EnesCanbolat/EE464_Project/PCB Design/Saturn Validation/via_validation.JPG

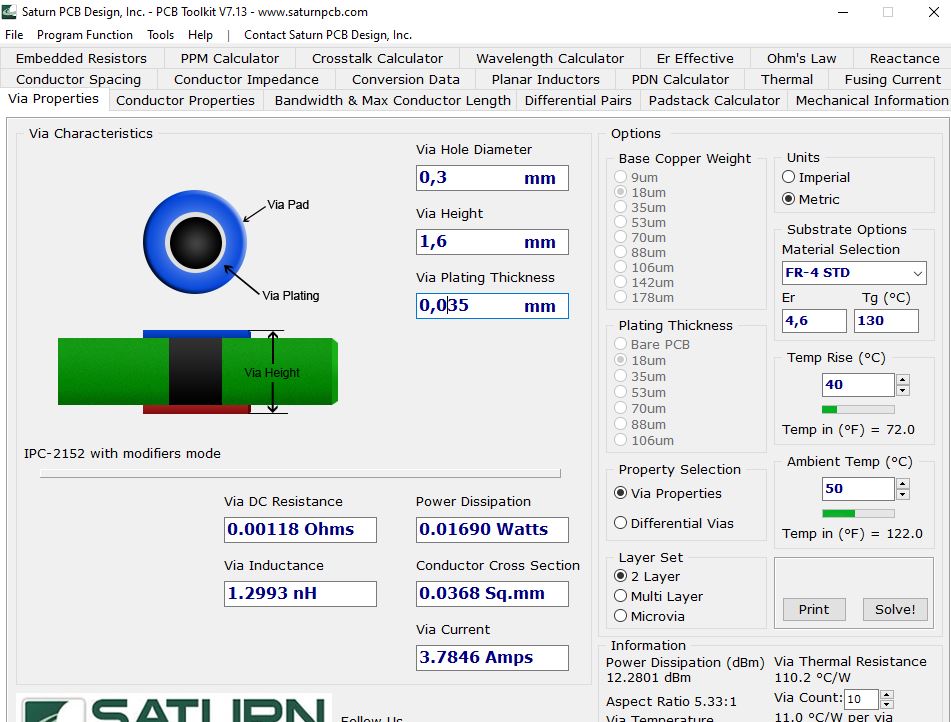
PCB Design/Saturn Validation/via_validation.JPG
