EnesCanbolat/EE464_Project/PCB Design/Saturn Validation/conductor_validation.JPG

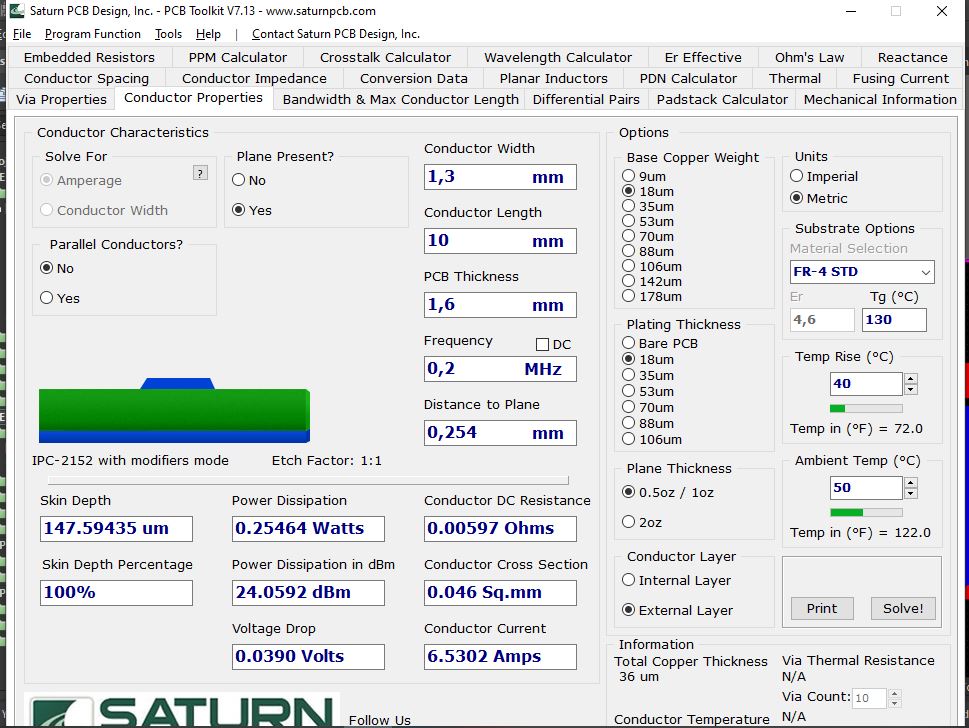
PCB Design/Saturn Validation/conductor_validation.JPG
