EnesCanbolat/EE464_Project/Report/Finished Parts/Hardware Design.docx

Hardware Design

a. Schematic Design

In this project, we have designed a schematic for our Flyback Converter hardware, by considering detailed simulation with LT8316 and DC2718A Demo Board Schematic, which is a 16V-600V input, 12V-3A output Flyback Converter demo board with LT8316. As a consequence of having a capable controller and tertiary winding transformer, we do not need any digital isolator (i.e. optocoupler) between two isolation boundaries. So, we have concluded our schematic with controller, transformer, connectors and some discrete components (discussed in component selection part) such as resistors, capacitors, diodes. We have not needed any extra ICs.

In component selection part, we have discussed feedback resistors, UVLO resistors and sense resistor for controller. However, there are some additional recommended components, that we placed in our schematic design. We can have a short discussion about these components:

IntVcc Pin: This pin is to maintain internal supply voltage that is taken from the Bias pin. In order to do that, datasheet recommends minimum 2.2uF capacitor, in schematic we have placed a 4.7uF capacitor.

Bias Pin: This pin takes the internal supply voltage from tertiary windings, so the datasheet recommends a bypass capacitor to ground. We have placed a 4.7uF ceramic capacitor, again.

Smode Pin: This pin is used for stand-by operation. In order yo avoid that we have connected it to ground.

Vc Pin: This pin is the Loop Compensation pin, which determines the switching frequency from the feedback voltage. Datasheet recommends an R-C network to stabilize the regulation generally with 20kohm resistor and 220nF capacitor. Normally decreasing R value and increasing C value causes transient problems and increasing R value and decreasing C value causes high frequency problems. However, when we examine the demo board discussed above, the R-C network is constructed with 10kohm resistor and 100nF capacitor. When we compare these values with the datasheet recommendation, we see that the demo board application gives better transient values, so we have used 10kohm resistor and 100nF capacitor in our hardware design.

IREG/SS Pin: This pin helps to regulate the output current. From this pin, 10uA current flows, and with the connected resistor, the voltage drop on the pin adjusts the current regulation. When we look datasheet, a formula is provided for this pin’s resistor, so when we calculate the needed resistor for 8.33A output current, we see that we need to connect a 50kohm resistor between this pin and ground.

TC Pin: This pin is used for Temperature Compensation, and from this pin to feedback pin a temperature compensation resistor is connected. Normally, there is a temperature coefficient that is found experimentally from the output diode voltage and temperature change, than the required resistance of this pin is calculated from this coefficient. However, in this project we are not able to implement that test, so we will use the demo board’s TC resistor which is 121kohm.

In addition to these recommended components by datasheet, we have used some additional components, which are input ceramic capacitors to compensate high frequency problems from input, and we have used a MOSFET gate resistor to limit the dI/dT ratio of gate current, and lastly we have used a gate pull-down resistor to prevent any failure which may occur from controller.

In figure 1, we can see the input connector and the input bypass capacitors, in figure 2 we can see the output connector, and finally in figure 3 we can see the schematic design of our Flyback Converter and controller.

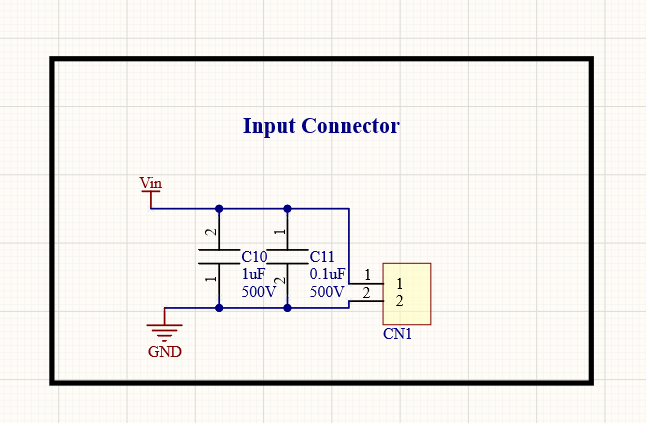
[picture p82: figure]

Figure 1: Input Connector and Input Bypass Capacitors

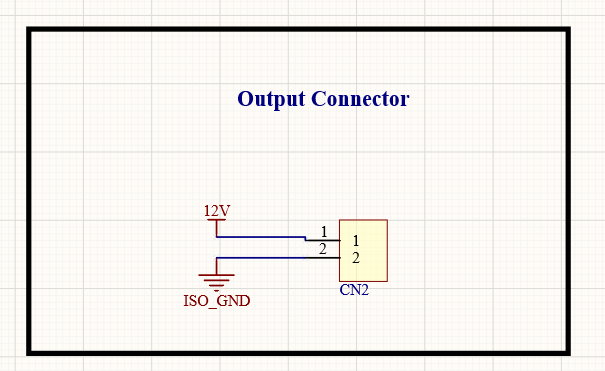
[picture p83: figure]

Figure 2: Output Connector


Figure 3: Flyback Converter and Controller

b. Bill of Materials and Budget

When we take bill of materials list from Altium Designer and select relevant components from Digikey, we have ended up with the table-1.

Manufacturer Part Number | Description | Unit Price | Extended Price USD
CL31B475KOHNFNE | CAP CER 4.7UF 16V X7R 1206 | 0,0442 | 88,40
885012005023 | CAP CER 4.7PF 16V C0G/NP0 0402 | 0,01188 | 23,76
885012206046 | CAP CER 0.1UF 16V X7R 0603 | 0,028 | 28,00
A750KK337M1CAAE014 | CAP ALUM POLY 330UF 20% 16V T/H | 0,18676 | 747,04
CHV1210N500104KXT | CAP CER 0.1UF 500V X7R 1210 | 0,109 | 109,00
CGA9P4X7T2W105K250KA | CAP CER 1UF 450V X7T 2220 | 1,3904 | 1.390,40
1714971 | TERM BLK 2P SIDE ENT 9.53MM PCB | 1,178 | 2.356,00
STPS1150A | DIODE SCHOTTKY 150V 1A SMA | 0,12421 | 124,21
SML4764A-E3/61 | DIODE ZENER 100V 1W DO214AC | 0,2057 | 370,26
SML4764A-E3/61 | DIODE ZENER 100V 1W DO214AC | 0,3388 | 67,76
ES1H | DIODE GEN PURP 500V 1A SMA | 0,10197 | 101,97
STPS30170DJF-TR | DIODE SCHOTTKY 170V 30A POWRFLAT | 0,54198 | 541,98
LT8316EFE#PBF | 600VIN MICROPOWER, ISOLATED NO-O | 3,105 | 3.105,00
IPD50R500CEAUMA1 | MOSFET N-CH 550V 7.6A TO252 | 0,40554 | 405,54
RT1206BRD0750KL | RES SMD 50K OHM 0.1% 1/4W 1206 | 0,11034 | 110,34
RT0603FRE07499KL | RES SMD 499K OHM 1% 1/10W 0603 | 0,01104 | 33,12
ESR03EZPJ912 | RES SMD 9.1K OHM 5% 1/4W 0603 | 0,01392 | 13,92
SFR03EZPJ103 | RES 10 KOHM 5% 1/10W 0603 | 0,0124 | 37,19
CRCW0603121KFKEAC | RES 121K OHM 1% 1/10W 0603 | 0,00652 | 6,52
CRCW060347K0FKEAC | RES SMD 47K OHM 1% 1/10W 0603 | 0,00652 | 6,52
CRCW08055K00JNTA | RES SMD 5K OHM 5% 1/8W 0805 | 0,02049 | 20,49
CFG0612-FX-R010ELF | RES 0.01 OHM 1% 1W 1206 | 0,064 | 64,00
CRCW120620R0FKEB | RES SMD 20 OHM 1% 1/4W 1206 | 0,01346 | 13,46
PC47EI25-Z | EI CORE SMPS TRANSFORMER 1 SET | 1,022 | 1.022,00
| | | 10786,88

Table-1: Bill of Materials

While constructing the BOM list, we have selected x1000 components, to prepare our budget for 1000 products. And as we see in table-1, the total price of the components for one card is nearly $10.8. With transformer cable and PCB manufacturing costs, the budget max exceed around $12.
