EnesCanbolat/EE464_Project/Presentations/464_FB_SUNUM Enes.pptx

EE463-Term Project

Martian Power Solutions

CEYHUN KOÇ 2166833
Enes Canbolat 2231546
EREN ÖZKARA 2232551

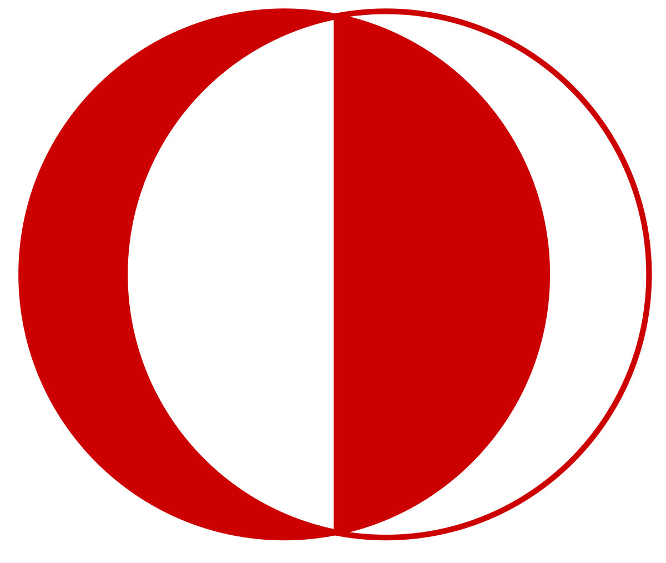
[picture p84: figure]
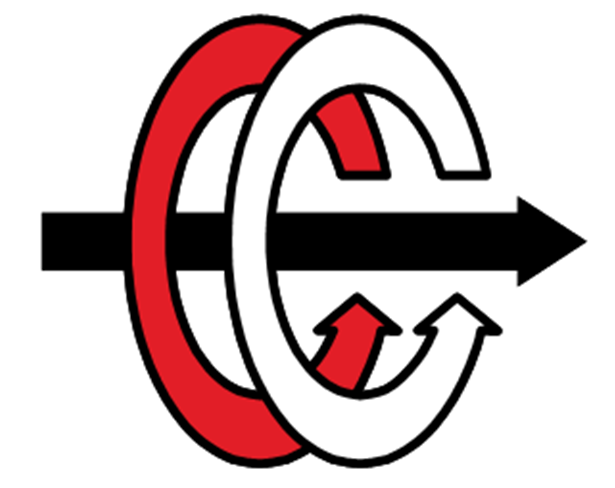
[picture p85: figure]
metin, küçük resim, vektör grafikler içeren bir resim Açıklama otomatik olarak oluşturuldu

## Table of Contents

1. Topology Selection
2. Operating Mode Selection
3. Analytical Calculations and Simulation
4. Magnetic Design
5. Component Selection and Controller
5.1. Controller
5.2 Discrete Component Selection
6. Detailed Simulation Results
7. Loss & Thermal Calculations
8. Hardware Design
9. Cost Analysis
10. Conclusion

## Slide 3

TOPOLOGY SELECTION

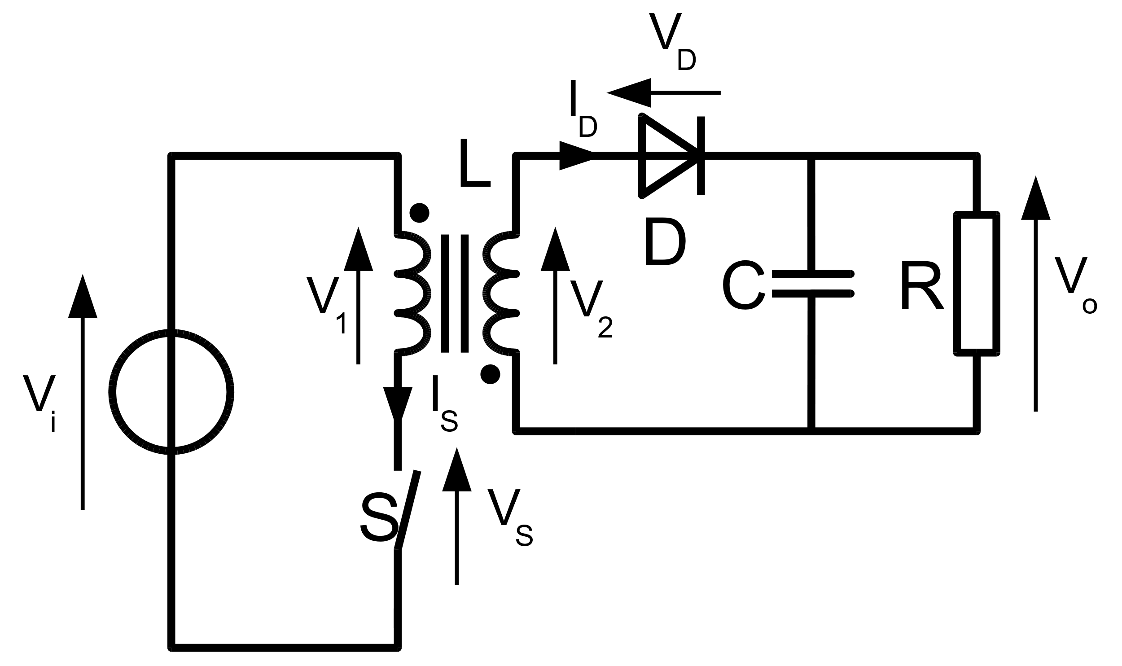
[picture p86: figure]

Notes: Flyback: Buck-boosttan elde ediliyor. En yaygın olarak tercih edilen, dolayısıyla çok fazla kaynak ve application note var. Düşük powerlar için uygun ama güzel dizayn edilmesi durumunda 10A’e kadar çalışıyor ki bu da uygun. CCM’den DCM’ye geçerken gainde ciddi bir kayıp yok.

## OPERATING MODE SELECTION

DCM

CCM

BOUNDARY

- Advantageous of them
- Controller Features
- Variable Frequency Operation

- Low Power Applications
- Better Switching Performance
- Smaller Transformer Size
- Higher Peak Current
- Higher RMS Current

- High Power Applications
- Worse Switching Performance
- Larger Transformer Size
- Low Peak Current
- Low RMS Current

Notes: DCM: diode yeni cycle başlamadan hemen önce akım geçmiyor. Yüksek akım ve yüksek peak output kapasitör üzerine çok daha fazla stres bindiriyor.
CCM: Düşük output akımı verebildiği için yüksek akımlarda daha iyi çalışabiliyor.
Analitik hesaplamalar için sözü Eren’e devrediyorum.

## Slide 5

## DETAILED SIMULATIONS

Output Voltage Performance


## DETAILED SIMULATIONS

Output Voltage Performance


Notes: 145ms civarında 12V’a ulaşıyor.

## DETAILED SIMULATIONS

Varying Input Voltage


Notes: Inputu 5 ms’de 220den 400’e yükselttik ve sonucu gözlemledik. (Line Regulation)

## DETAILED SIMULATIONS

Output Voltage Performance for Varying Input Voltage


Notes: Çok küçük oynamalarla 12V sabit kaldı diyebiliriz.

## DETAILED SIMULATIONS

Output Voltage Ripple for 220V (left) and 400V(right) Input Voltage


Notes: Output ripple 0.1Voltun altında (iki ekstrem durum için de geçerli)

## DETAILED SIMULATIONS

Output Current Ripple for 220V (left) and 400V(right) Input Voltage

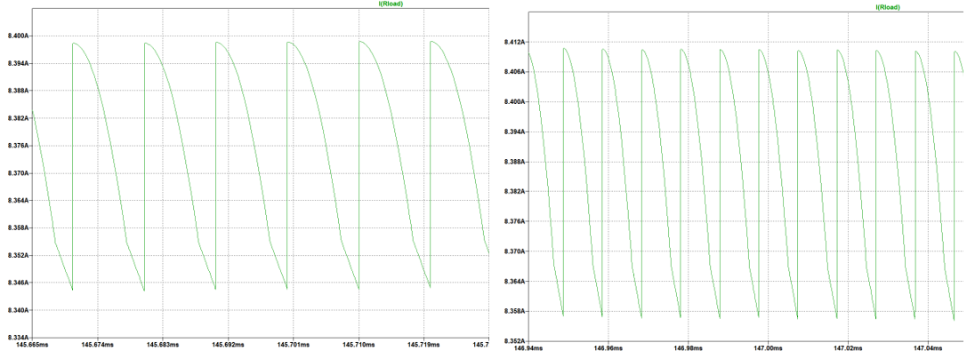
[picture p87: figure]

Notes: 0.05A civarında bir ripple var ve 8A civarında average

## DETAILED SIMULATIONS

Output Load Regulation Performance


Notes: Load Regulation yaklaşık 0.35V dğşüş var bu da %3 sınırında

## DETAILED SIMULATIONS

Output Capacitor Current Ripple for 220V (left) and 400V(right) Input Voltage


Notes: Yaklaşık 20A civarında bir ripple var kapasitör voltajı da output voltajı ile aynı zaten.

## DETAILED SIMULATIONS

One of the Output Diode Current Waveform for 220V (left) and 400V(right) Input Voltage


Notes: Toplam 22-23A civarında bir akım geçiyor, diyot başına 4.7-4.8A peak

## DETAILED SIMULATIONS

Output Diode Voltage Waveform for 220V (left) and 400V(right) Input Voltage


Notes: Input voltajına göre çok değişken bir reverse voltaj değeri var ve input 400V olduğunda diyotun 110V’a kadar dayanması gerekiyor.

## DETAILED SIMULATIONS

MOSFET Gate Voltage Waveform for 220V (left) and 400V(right) Input Voltage


Notes: Gate’i 10V civarında bir gerilim tutuyor

## DETAILED SIMULATIONS

MOSFET Gate Current Waveform for 220V (left) and 400V(right) Input Voltage


Notes: Ayrıca 5.1A civarında bir peak akım değeri gözlemledik

## DETAILED SIMULATIONS

MOSFET Gate Voltage Waveform for 220V (left) and 400V(right) Input Voltage

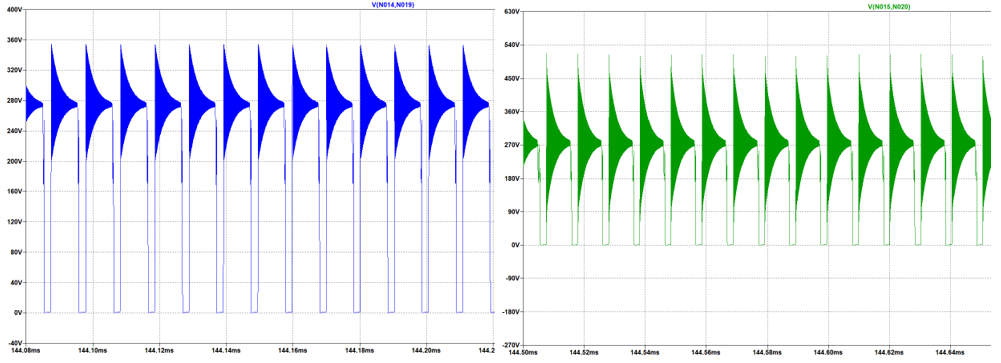
[picture p88: figure]

Notes: Ayrıca MOSFET’in üzerinde input voltajı 400 olduğunda 480V kadar bir gerilim tutuyor. Bu da uygun ve snubber ın düzgün çalıştığını gösterir.

## DETAILED SIMULATIONS

Snubber Diode Voltage Waveform for 220V (left) and 400V(right) Input Voltage


Notes: 520Va kadar dayanması gerekiyor

## DETAILED SIMULATIONS

Power Loss on the Snubber Resistor for 220V (left) and 400V(right) Input Voltage


Notes: Direnç üzerinde3W civarında bir kayıp var. Daha detaylı analiz için sözü Eren’e bırakıyorum.
