EnesCanbolat/EE464_Project/Presentations/FinalPresentation_Eren.pptx

EE464-Term Project

Martian Power Solutions

CEYHUN KOÇ 2166833
Enes Canbolat 2231546
EREN ÖZKARA 2232551

metin, küçük resim, vektör grafikler içeren bir resim Açıklama otomatik olarak oluşturuldu

## Analytical Calculations Before Simulation

V_(out) =V_(in) (D/(1−D))((N2)/(N1))

L_(Mmin) =(((1−D)^2 R)/(2f))((N1)/(N2))^2

V_(sw_open) =V_(in) +V_(out) ∗N, V_(sw_(max)) =448 V

V_(in) =220 V , D=0.18;V_(in) =400 V , D=0.11

f=100 kHz, L_(Mmin) =91.25μ H

ΔV_(o,ESR) =I_(LM,max) ∗((N1)/(N2))∗r_c , r_c <0.025 ohm

ΔV_o =(ΔQ)/C=(V_o ∗D∗T_s)/(R∗C), (ΔV_o)/(V_o)≤0.04, C≥31.25 μF

## Simulations


Fig. 1 Flyback Converter Simulink Model

## Slide 4


Fig. 2 Magnetizing Current of the Flyback Converter

Simulations

## Slide 5


Fig. 3 Output Voltage of the Flyback Converter

Simulations

## Slide 6


Fig. 4 Switch Voltage of the Flyback Converter

Simulations

## Magnetic Design


Fig. 5 Transformer Schematic

## Slide 8

VO=Vout+V_F , VO=12+1=13 V

VOR=VO∗(Np)/(Ns), VOR=13∗26/6=56.333 V

Dmax=(VOR)/((Vin_min+VOR)), Dmax=0.204

Magnetic Design

## Slide 9

Iout_(max) =(Pout)/(Vout), Iout_(max) =8.333 A

Ls=((Vout+V_F )∗(1−D_(max) )^2)/(2∗Iout_(max) ∗fsw_(max)), Ls≤4.9μH, Ls=4.34μH

Ispk=(2∗Iout_(max))/(1−D_(max))=20.1 A

Lp=Ls∗((Np)/(Ns))^2 =81.5 μH

Ippk=(Ispk)/(Np/Ns)=4.83 A

Magnetic Design

## Slide 10

Table. 1 Magnetic Properties

Core Type | Effective Cross-Sectional Area Ae (mm2) | Maximum Magnetic Flux Density (T) | AL-Value with Air Gap (nH/N^2)
PC47EI25 | 41 | 0.42 | 125

Fill Factor : EI40, EI30 < 0.4,
EI25 = 0.41

Table. 2 Core Dimensions

Core | A (mm) | C(mm) | D (mm) | E(mm) | F (mm)
EI25 | 25.3 | 5.75 | 6.5 | 19 | 12.35


Magnetic Metarial and Core Selection

## Slide 11

Np=(Vin∗D∗Ts)/(Ae∗Bsat)=Lp∗(Ippk)/(Ae∗Bsat)=22.8, Np≥22.8

Np=√((Lp)/(AL))=25.53, Np=25

MMF=Np∗Ippk=120.75 At

Ns=((Np)/(Np))/(Ns)=6

Nd=6

Calculation of Winding Turns Ratio

## Slide 12

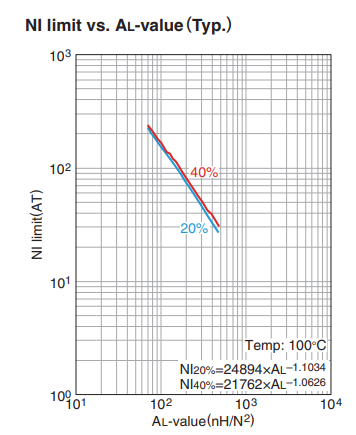
[picture p89: figure]
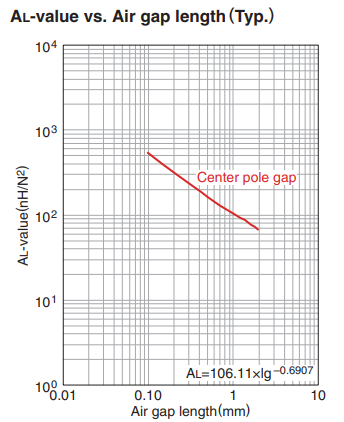
[picture p90: figure]

Fig. 5 NI limit and Air gap vs AL value Graphs

Datasheet of PC47EI25

## Slide 13

Vp_(rms) ∗Ip_(rms) =(Np∗Ae∗Bsat)/(D∗Ts)∗Ip_(rms) =P_o =197.5 W

Vp_(rms) ∗Ip_(rms) =100 W=(Np∗Ae∗B_(operating))/(D∗Ts)∗Ip_(rms) , B_(operating) =0.2 T

Power Calculation of Transformer

## Slide 14

Table. 2 Selected Cable Properties

Wire | Area (mm2) | Diameter(mm) | Ampacity(A) (75°C) | Resistivity (p) (10^-8 Ω.m) | Absolute magnetic permeability (u) (10^-7 H/m)
AWG10 | 5.26 | 2.588 | 35 | 1.678 | 12.55
AWG20 | 0.518 | 0.812 | 11 | 1.678 | 12.55
AWG30 | 0.509 | 0.255 | 0.86 | 1.678 | 12.55

Fill_(Factor) =(Cable_A)/(Window_A)=48/116.1=0.41

Cable Selection

## Slide 15

length=(C+(D+E)/2)∗2, AWG20_(length) =length∗Np=0.962 m

Skin_(depth) =√((p/(π∗f∗u)))=207μm

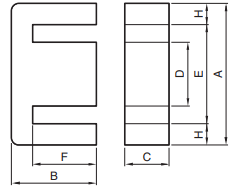
[picture p91: figure]

Effective_(Area) =Skin_(depth) ∗pi∗Diameter,
A_(eff_(AWG20)) =Skin_(depth) ∗π∗AWG20_d =0.528mm2

R_(AC) =p∗(length)/(Effective_(Area)), R_(AC_20) =p∗(AWG20_(length))/(A_(eff_(AWG20)))=61 mΩ

AWG 10 → 4 mΩ
AWG 20 → 61 mΩ
AWG 30 → 44 mΩ

More than 2 W Copper Loss (Proximity effect is ignored)

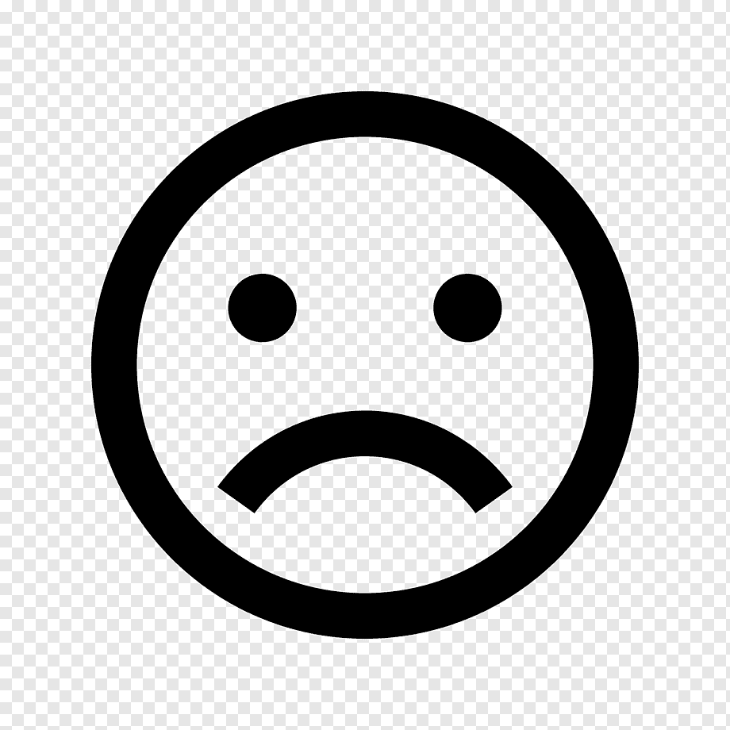
[picture p92: figure]

Skin Depth and R Calculation

## Slide 16

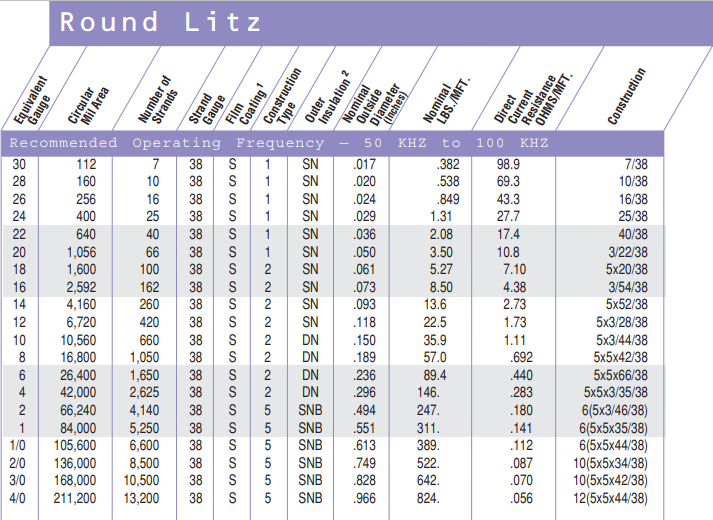
[picture p93: figure]

Nb → # of bunching operations
Nc → # of cabling operations
Ns → # of individual strands

Rdc=(RS∗((1.02)^(Nb) )∗((1.03)^(Nc) ))/(Ns)

R_(AC_10) =0.8 mΩ,
R_(AC_20) =34.6 mΩ,
R_(AC_30) =73.1 mΩ

The copper loss decreased to 0.1 W thanks to the Litz wire !

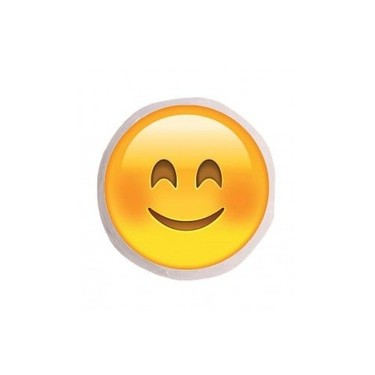
[picture p94: figure]
küçük resim içeren bir resim Açıklama otomatik olarak oluşturuldu

Litz Wire

## Power Calculations

Iout_(avg) =(Pout)/(Vout), Iout_(avg) =8.333 A

P_(diode) =V_F ∗Iout_(avg) =8.333 W

P_(secondary) =P_(out) +P_(diode) =108.33 W

P_(primary) =(P_(secondary))/(η_(transformer))=120.367 W

V_(in) =220 V, Dmax=0.21, Iin_(avg) =(P_(in))/(V_(in))=0.568 A

Iin_(peak) =2∗(Iin_(avg))/(Dmax)=5.4 A

V_(in) =400 V, Dmin=0.12, Iin_(avg) =(P_(in))/(V_(in))=0.3125 A

Iin_(peak) =2∗(Iin_(avg))/(Dmin)=5.2 A

## Slide 18


Secondary Side Diode Current

Ddwell=0.05∗D∗Ts

Isec_(peak(max)) =2∗(Iout_(avg))/((1−Ddwell−Dmax))=22.52 A

Power Calculation

## Slide 19

Loss mechanism | Component | Model
Conduction | MOSFET | P_(on,M) = Iin^2 R_(on,M)
Switching | MOSFET | P_(sw,M) = 1/2V_(sw) I_(in) (t_(rise) +t_(fall) )f_(sw)
Switching – Output capacitance | MOSFET | P_(coss) = 1/2V_(sw)^2 (C_(DS) +C_(GD) )f_(sw) P_(coss) =E_(coss) f_(sw)
Switching – Gate charge | MOSFET | P_G =Q_g V_(gs) f_(sw)
Switching | MOSFET Diode | P_(bodydiode) =1/2V_(sw) I_(RR) t_(RR) f_(sw)
Conduction | Diode | P_(on,D) =V_f I_(out)
Conduction – Copper loss | Transformer | P_(copper) =Iin_(rms)^2 R_(pri) +Iout_(rms)^2 R_(sec) +I_(third) ^2 R_(third)
Magnetic Loss | Transformer | P_(core) =a∗(f^x )∗(B_(op)^y )∗V_(core)
Conduction | Shunt resistor | P_(shunt) =Iin_(rms)^2 R_(shunt)
RCD Snubber | Resistor-Diode | P_(on,D) =V_f I_(RCD) , P_(shunt) =I_(RDC,rms)^2 R_(RCD)

Power Calculation Table

## Slide 20


Power Calculation Results

## Thermal Calculations


Schematic of Junction Temperature without and with Heatsink

## Slide 22

MOSFET

RthJA,TYP - RthJA,MAX: 35°C/W - 62°C/W
RDS | Assumed TJ | Max. Power Loss | Calculated max TJ
0.50Ω | 25°C | 0.54 W | 58°C
0.60Ω | 58°C | 0.57 W | 60.3°C
0.61Ω | 60.3°C | 0.58W | 61°C
0.61Ω | 61°C | 0.58W | 61°C

No need to heatsink since MOSFET can operate up to 150°C


Typical Forward Current Derating Curve of the Diode

Snubber diode just consume 15mW.

5 Output Diode

T_(junc) = 25°C + 1.64∗55 = 115.2°C, T_(ambient) =25°C
T_(junc) = 40°C + 1.64∗55 = 130.2°C, T_(ambient) =40°C

Thermal Calculation
