EnesCanbolat/EE464_Project/Box/box top.JPG

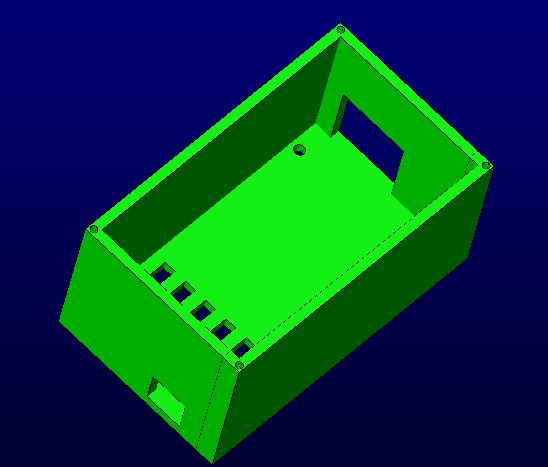
Box/box top.JPG
