EnesCanbolat/EE464_Project/Final BOM.xlsx

Index | Manufacturer Part Number | Manufacturer Name | Description | Attrition % | Requested Quantity 1 | Pack Quantity 1 | Pack Type 1 | Digi-Key Part Number 1 | Unit Price 1 | Extended Price ($)
1 | CL31B475KOHNNNE | Samsung Electro-Mechanics | CAP CER 4.7UF 16V X7R 1206 |  | 2000 | 2000 | Tape & Reel (TR) | 1276-3182-2-ND | 0.05220 | 104.39
2 | 0603N470J101CT | Walsin Technology Corporation | CAP CER 47PF 100V C0G/NP0 0603 |  | 2000 | 2000 | Cut Tape (CT) | 1292-1527-1-ND | 0.01281 | 25.62
3 | A750KK337M1CAAE014 | KEMET | CAP ALUM POLY 330UF 20% 16V T/H |  | 4000 | 4000 | Bulk | 399-13677-ND | 0.18676 | 747.04
4 | 885012206046 | Würth Elektronik | CAP CER 0.1UF 16V X7R 0603 |  | 1000 | 1000 | Cut Tape (CT) | 732-7965-1-ND | 0.02400 | 24
5 | C1210C104KCRACTU | KEMET | CAP CER 0.1UF 500V X7R 1210 |  | 1000 | 1000 | Cut Tape (CT) | 399-6747-1-ND | 0.12644 | 126.44
6 | CGA9P4X7T2W105K250KA | TDK Corporation | CAP CER 1UF 450V X7T 2220 |  | 1000 | 1000 | Tape & Reel (TR) | 445-7952-2-ND | 1.39040 | 1390.4
7 | C1206C104K2REC7800 | KEMET | CAP CER 1206 0.1UF 200V X7R |  | 1000 | 1000 | Cut Tape (CT) | 399-C1206C104K2REC7800CT-ND | 0.06401 | 64.01
8 | 282858-2 | TE Connectivity AMP Connectors | TERM BLK 2P SIDE ENTRY 10MM PCB |  | 1000 | 1000 | Box | A98113-ND | 0.62589 | 625.89
9 | 691103110002 | Würth Elektronik | TERM BLK 2POS SIDE ENT 3.5MM PCB |  | 1000 | 1000 | Box | 732-2745-ND | 0.53800 | 538
10 | ES1CHE3_A/H | Vishay General Semiconductor - Diodes Division | DIODE GEN PURP 150V 1A DO214AC |  | 1000 | 1000 | Cut Tape (CT) | ES1CHE3_A/HGICT-ND | 0.17160 | 171.6
11 | S1J-E3/61T | Vishay General Semiconductor - Diodes Division | DIODE GEN PURP 600V 1A DO214AC |  | 1000 | 1000 | Cut Tape (CT) | S1J-E3/61TGICT-ND | 0.09694 | 96.94
12 | CDBB3150-HF | Comchip Technology | DIODE SCHOTTKY 150V 3A DO214AA |  | 3000 | 3000 | Tape & Reel (TR) | 641-1720-2-ND | 0.16470 | 494.11
13 | CDBB3150-HF | Comchip Technology | DIODE SCHOTTKY 150V 3A DO214AA |  | 2000 | 2000 | Cut Tape (CT) | 641-1720-1-ND | 0.18064 | 361.28
14 | LT8316EFE#PBF | Analog Devices Inc. | 600VIN MICROPOWER, ISOLATED NO-O |  | 1000 | 1000 | Tube | LT8316EFE#PBF-ND | 3.10500 | 3105
15 | IPD50R500CEAUMA1 | Infineon Technologies | MOSFET N-CH 550V 7.6A TO252 |  | 1000 | 1000 | Cut Tape (CT) | IPD50R500CEAUMA1CT-ND | 0.40554 | 405.54
16 | RT1206BRD0750KL | Yageo | RES SMD 50K OHM 0.1% 1/4W 1206 |  | 1000 | 1000 | Cut Tape (CT) | 13-RT1206BRD0750KLCT-ND | 0.11034 | 110.34
17 | RC1206FR-07499KL | Yageo | RES SMD 499K OHM 1% 1/4W 1206 |  | 3000 | 3000 | Cut Tape (CT) | 311-499KFRCT-ND | 0.01174 | 35.23
18 | ESR03EZPJ912 | Rohm Semiconductor | RES SMD 9.1K OHM 5% 1/4W 0603 |  | 1000 | 1000 | Cut Tape (CT) | RHM9.1KDCT-ND | 0.01392 | 13.92
19 | SFR03EZPJ103 | Rohm Semiconductor | RES 10 KOHM 5% 1/10W 0603 |  | 2000 | 2000 | Cut Tape (CT) | 511-1825-1-ND | 0.01493 | 29.86
20 | CRCW0603121KFKEAC | Vishay Dale | RES 121K OHM 1% 1/10W 0603 |  | 1000 | 1000 | Cut Tape (CT) | 541-5152-1-ND | 0.00652 | 6.52
21 | CRCW060347K0FKEAC | Vishay Dale | RES 47K OHM 1% 1/10W 0603 |  | 1000 | 1000 | Cut Tape (CT) | 541-4021-1-ND | 0.00652 | 6.52
22 | CRCW08055K00JNTA | Vishay Dale | RES SMD 5K OHM 5% 1/8W 0805 |  | 1000 | 1000 | Cut Tape (CT) | 541-CRCW08055K00JNTACT-ND | 0.02049 | 20.49
23 | ERJ-3EKF1502V | Panasonic Electronic Components | RES SMD 15K OHM 1% 1/10W 0603 |  | 1000 | 1000 | Cut Tape (CT) | P15.0KHCT-ND | 0.00677 | 6.77
24 | CFG0612-FX-R010ELF | Bourns Inc. | RES 0.01 OHM 1% 1W 1206 |  | 1000 | 1000 | Cut Tape (CT) | CFG0612-FX-R010ELFCT-ND | 0.06400 | 64
25 | RNCP0603FTD20R0 | Stackpole Electronics Inc | RES 20 OHM 1% 1/8W 0603 |  | 1000 | 1000 | Cut Tape (CT) | RNCP0603FTD20R0CT-ND | 0.01060 | 10.6
26 | RMCF0603FT5K60 | Stackpole Electronics Inc | RES 5.6K OHM 1% 1/10W 0603 |  | 1000 | 1000 | Cut Tape (CT) | RMCF0603FT5K60CT-ND | 0.00305 | 3.05
27 | PC47EI25-Z | TDK Corporation | EI CORE SMPS TRANSFORMER 1 SET |  | 1000 | 1000 | Tray | 445-181471-ND | 1.02213 | 1022.13
28 | SMBJE400CA | Eaton - Electronics Division | TVS DIODE 400VWM 648VC SMB |  | 1000 | 1000 | Cut Tape (CT) | 283-SMBJE400CACT-ND | 0.17017 | 170.17
 |  |  |  |  |  |  |  |  |  | 9779.86
 | PCB Price |  |  |  |  |  |  |  |  | 197
