EnesCanbolat/EE464_Project/Report/Finished Parts/bom.xlsx

Index | Quantity | Part Number | Manufacturer Part Number | Description | Customer Reference | Available | Backorder | Unit Price | Extended Price USD
1 | 2000 | 1276-3181-2-ND | CL31B475KOHNFNE | CAP CER 4.7UF 16V X7R 1206 |  | 2000 | 0 | 0.0442 | 88.40
2 | 2000 | 732-7439-1-ND | 885012005023 | CAP CER 4.7PF 16V C0G/NP0 0402 |  | 2000 | 0 | 0.01188 | 23.76
3 | 1000 | 732-7965-1-ND | 885012206046 | CAP CER 0.1UF 16V X7R 0603 |  | 1000 | 0 | 0.028 | 28.00
4 | 4000 | 399-13677-ND | A750KK337M1CAAE014 | CAP ALUM POLY 330UF 20% 16V T/H |  | 4000 | 0 | 0.18676 | 747.04
5 | 1000 | 2571-CHV1210N500104KXTTR-ND | CHV1210N500104KXT | CAP CER 0.1UF 500V X7R 1210 |  | 1000 | 0 | 0.109 | 109.00
6 | 1000 | 445-7952-2-ND | CGA9P4X7T2W105K250KA | CAP CER 1UF 450V X7T 2220 |  | 1000 | 0 | 1.3904 | 1390.40
7 | 2000 | 277-1271-ND | 1714971 | TERM BLK 2P SIDE ENT 9.53MM PCB |  | 2000 | 0 | 1.178 | 2356.00
8 | 1000 | 497-7545-1-ND | STPS1150A | DIODE SCHOTTKY 150V 1A SMA |  | 1000 | 0 | 0.12421 | 124.21
9 | 1800 | SML4764A-E3/61TR-ND | SML4764A-E3/61 | DIODE ZENER 100V 1W DO214AC |  | 0 | 1800 | 0.2057 | 370.26
10 | 200 | SML4764A-E3/61CT-ND | SML4764A-E3/61 | DIODE ZENER 100V 1W DO214AC |  | 200 | 0 | 0.3388 | 67.76
11 | 1000 | ES1HCT-ND | ES1H | DIODE GEN PURP 500V 1A SMA |  | 1000 | 0 | 0.10197 | 101.97
12 | 1000 | 497-10344-1-ND | STPS30170DJF-TR | DIODE SCHOTTKY 170V 30A POWRFLAT |  | 1000 | 0 | 0.54198 | 541.98
13 | 1000 | LT8316EFE#PBF-ND | LT8316EFE#PBF | 600VIN MICROPOWER, ISOLATED NO-O |  | 208 | 792 | 3.105 | 3105.00
14 | 1000 | IPD50R500CEAUMA1CT-ND | IPD50R500CEAUMA1 | MOSFET N-CH 550V 7.6A TO252 |  | 822 | 178 | 0.40554 | 405.54
15 | 1000 | 13-RT1206BRD0750KLCT-ND | RT1206BRD0750KL | RES SMD 50K OHM 0.1% 1/4W 1206 |  | 1000 | 0 | 0.11034 | 110.34
16 | 3000 | 13-RT0603FRE07499KLCT-ND | RT0603FRE07499KL | RES SMD 499K OHM 1% 1/10W 0603 |  | 80 | 2920 | 0.01104 | 33.12
17 | 1000 | RHM9.1KDCT-ND | ESR03EZPJ912 | RES SMD 9.1K OHM 5% 1/4W 0603 |  | 1000 | 0 | 0.01392 | 13.92
18 | 3000 | 511-1825-1-ND | SFR03EZPJ103 | RES 10 KOHM 5% 1/10W 0603 |  | 3000 | 0 | 0.0124 | 37.19
19 | 1000 | 541-5152-1-ND | CRCW0603121KFKEAC | RES 121K OHM 1% 1/10W 0603 |  | 1000 | 0 | 0.00652 | 6.52
20 | 1000 | 541-4021-1-ND | CRCW060347K0FKEAC | RES SMD 47K OHM 1% 1/10W 0603 |  | 1000 | 0 | 0.00652 | 6.52
21 | 1000 | 541-CRCW08055K00JNTACT-ND | CRCW08055K00JNTA | RES SMD 5K OHM 5% 1/8W 0805 |  | 1000 | 0 | 0.02049 | 20.49
22 | 1000 | CFG0612-FX-R010ELFCT-ND | CFG0612-FX-R010ELF | RES 0.01 OHM 1% 1W 1206 |  | 74 | 926 | 0.064 | 64.00
23 | 1000 | 541-CRCW120620R0FKEBCT-ND | CRCW120620R0FKEB | RES SMD 20 OHM 1% 1/4W 1206 |  | 1000 | 0 | 0.01346 | 13.46
24 | 1000 | 445-181471-ND | PC47EI25-Z | EI CORE SMPS TRANSFORMER 1 SET |  | 195 | 805 | 1.022 | 1022.00
 |  |  |  |  |  |  |  |  | 10786.88
