EnesCanbolat/EE464_Project/PCB Design/EE464_Project/Project Outputs for EE464_Project/EE464_Project_BOM.xlsx

Comment | Description | Designator | Footprint | LibRef | Quantity
CAP 4.7uF |  | C1, C3 |  | CAP 4.7uF | 2 | CL31B475KOHNFNE (https://www.digikey.com/en/products/detail/samsung-electro-mechanics/CL31B475KOHNFNE/3888839)
CAP 47pF |  | C2, C4 |  | CAP 47pF | 2 | ‎885012005023‎
CAP 100nF |  | C5 | 0603_CAP | CAP 100nF | 1 | 0.885012206
A750KK337M1CAAE014 | CAP,330uF,AL.POLY.,16V, A750KK337M1CAAE014 | C6, C7, C8, C9 | CAPPRD350W65D800H900 | CAP 330uF AL. POLY. | 4
CAP 1uF 500v |  | C10 |  | CAP 1uF 500v | 1 | CGA9P4X7T2W105K250KA
CAP 0.1uF 500V |  | C11 |  | CAP 0.1uF 500V | 1 | CHV1210N500104KXT | 1210
CONN KLE_2_2 |  | CN1, CN2 |  | CONN KLE_2_2 | 2 | 1714971
DI SK115 | DI, SK115, 150V, 1A, SMA | D1 | DIOM5227X270N | DI SK115 | 1 | STPS1150A
DI Z2SMB100 | DI, Z2SMB100, 100V, Zener, 60ohm, SMB | D2, D3 | S2GTR | DI Z2SMB100 | 2 | SML4764A-E3/61
DI ES1H | DI, ES1H, 450V, Fast Recovery, SMA | D4 | DIOM5227X270N | DI ES1H | 1 | oo
DI STPS30170DJF-TR | DI, STPS30170DJF-TR, 170V, 30A, PowerFlat | D5 | STPS30170DJFTR | DI STPS30170DJF-TR | 1 | oo
IC LT8316EFEPB | IC, PMIC, Flyback Controller, 16-600V, 100W | IC1 | LT8316IFEPBF | IC LT8316EFEPB | 1 | oo
MOS, N-CH, IPD50R500CEAUMA1 |  | M1 |  | MOS, N-CH, IPD50R500CEAUMA1 | 1 | OO
RES, 50K, 0603 |  | R1 |  | RES, 50K, 0603 | 1 | RT1206BRD0750KL | 1206
RES, 499K, 1206 |  | R2, R3, R4 |  | RES, 499K, 1206 | 3 | RT0603FRE07499KL‎ | 603
RES, 9.2K, 0603 |  | R5 |  | RES, 9.2K, 0603 | 1 | ESR03EZPJ912 | 603
RES, 10K, 0603 |  | R6, R10, R13 | 0603_RES | RES, 10K, 0603 | 3 | SFR03EZPJ103 | 603
RES, 121K, 0603 |  | R7 |  | RES, 121K, 0603 | 1 | CRCW0603121KFKEAC | 603
RES, 47K, 0603 |  | R8 |  | RES, 47K, 0603 | 1 | CRCW060347K0FKEAC | 603
RES, 5K, 0603 |  | R9 |  | RES, 5K, 0603 | 1 | CRCW08055K00JNTA | 805
RES, 0.01,1206 |  | R11 |  | RES, 0.01,1206 | 1 | CFG0612-FX-R010ELF | 1206
RES, 20, 0603 |  | R12 | 0603_RES | RES, 20, 0603 | 1 | CRCW120620R0FKEB | 1206
TF 4:1 |  | TF? |  | TF 4:1 | 1 | PC47EI25
