EnesCanbolat/EE464_Project/PCB Design/EE464_Project/Project Outputs for EE464_Project/EE464_Project_2206.xlsx

Comment | Description | Designator | Footprint | LibRef | Quantity
CAP 4.7uF 1206 |  | C1, C2 | CAP_1206 | CAP 4.7uF 1206 | 2
CAP 47pF 0603 |  | C3, C4 | 0603_CAP | CAP 47pF 0603 | 2
CAP 100nF |  | C5 | 0603_CAP | CAP 100nF | 1
A750KK337M1CAAE014 | CAP,330uF,AL.POLY.,16V, A750KK337M1CAAE014 | C6, C7, C8, C9 | CAPPRD350W65D800H900 | CAP 330uF AL. POLY. | 4
CAP 0.1uF 500V 1210 |  | C10 | CAP_1210 | CAP 0.1uF 500V 1210 | 1
CAP 1uF 500v |  | C11 | CAP_2210 | CAP 1uF 500v | 1
CAP, 0.1u, 200V, 1206 |  | C12 | CAP_1206 | CAP, 0.1u, 200V, 1206 | 1
CONN_KLE_2_HV |  | CN1 | 2828582 | CONN_KLE_2_HV | 1
CONN_KLE_2_LV |  | CN2 | 691103110002 | CONN_KLE_2_LV | 1
DI SK115 | DI, SK115, 150V, 1A, SMA | D1 | DIOM5227X270N | DI SK115 | 1 | ES1CHE3_A/H
DI S1J-E3/61T 600V 1A SMA |  | D2 | DIOM5227X270N | DI S1J-E3/61T 600V 1A SMA | 1
DI CDBB3150-HF 150V 3A SMB |  | D3, D4, D5, D6, D7 | S2GTR | DI CDBB3150-HF 150V 3A SMB | 5
IC LT8316EFEPB | IC, PMIC, Flyback Controller, 16-600V, 100W | IC1 | LT8316IFEPBF | IC LT8316EFEPB | 1
MOS, N-CH, IPD50R500CEAUMA1 |  | M1 | FDD5N50NZ | MOS, N-CH, IPD50R500CEAUMA1 | 1
RES, 50K, 1206 |  | R1 | RES_1206 | RES, 50K, 1206 | 1
RES, 499K, 1206 |  | R2, R3, R4 | RES_1206 | RES, 499K, 1206 | 3
RES, 9.2K, 0603 |  | R5 | 0603_RES | RES, 9.2K, 0603 | 1
RES, 10K, 0603 |  | R6, R13 | 0603_RES | RES, 10K, 0603 | 2
RES, 121K, 0603 |  | R7 | 0603_RES | RES, 121K, 0603 | 1
RES, 47K, 0603 |  | R8 | 0603_RES | RES, 47K, 0603 | 1
RES, 5K, 0805 |  | R9 | RES_0805 | RES, 5K, 0805 | 1
RES, 15K, 0603 |  | R10 | 0603_RES | RES, 15K, 0603 | 1
RES, 0.01,1206 |  | R11 | RES_1206 | RES, 0.01,1206 | 1
RES, 20, 0603 |  | R12 | 0603_RES | RES, 20, 0603 | 1
RES, 5K6, 0603 |  | R14 | 0603_RES | RES, 5K6, 0603 | 1
TF 4:1 |  | TF1 | tf_mount | TF 4:1 | 1
TVS DI SMBJE400CA 400V SMB |  | TVS1 | S2GTR | TVS DI SMBJE400CA 400V SMB | 1
