EnesCanbolat/EE464_Project/Report/Finished Parts/Detailed Simulation Results.docx

Figure 1 Circuit Diagram


Figure 2 Varying Input Voltage


Figure 3 Output Voltage Performance for Varying Input Voltage


Figure 4 Output Voltage Ripple for Varying Input Voltage

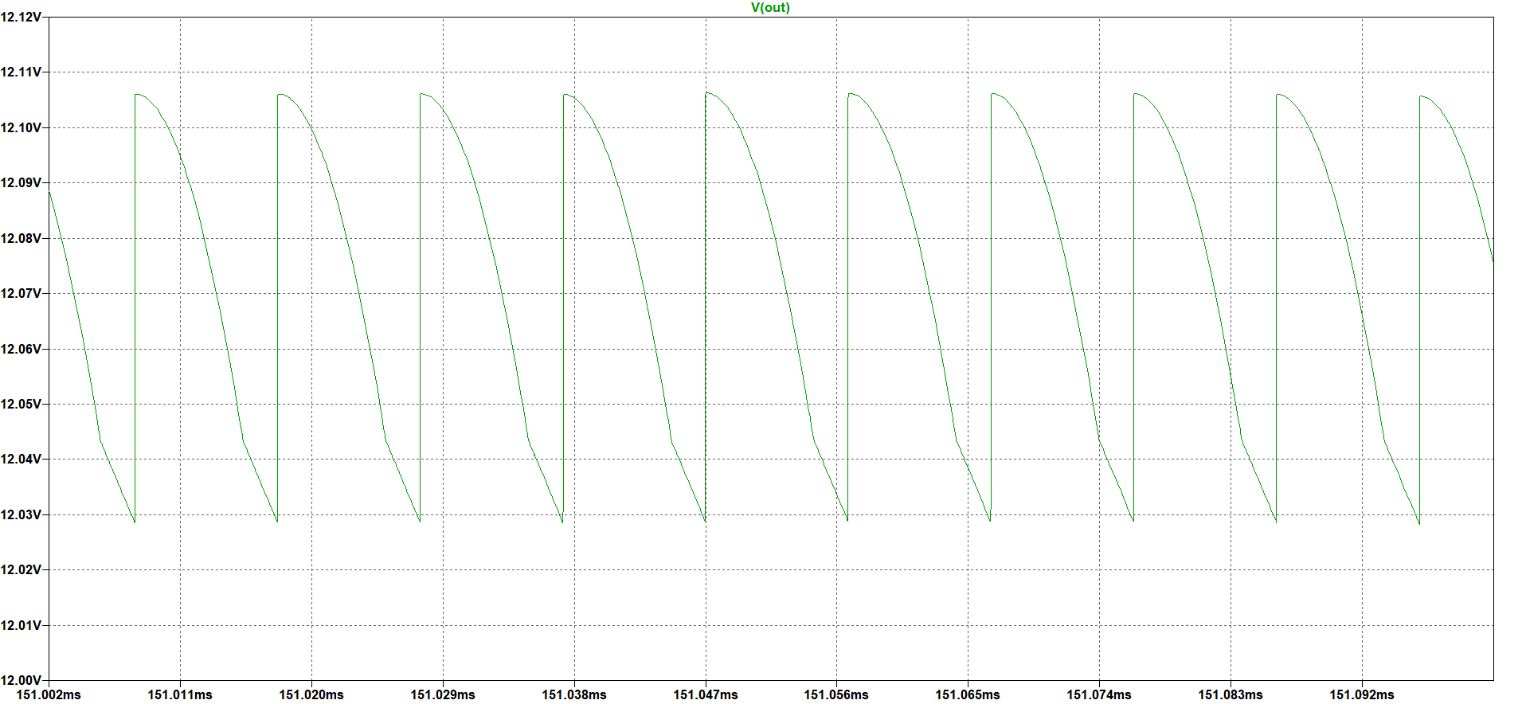
[picture p155: figure]

Figure 5 Output Voltage Ripple for 220 V Input Voltage


Figure 6 Output Voltage for 220V Input Voltage

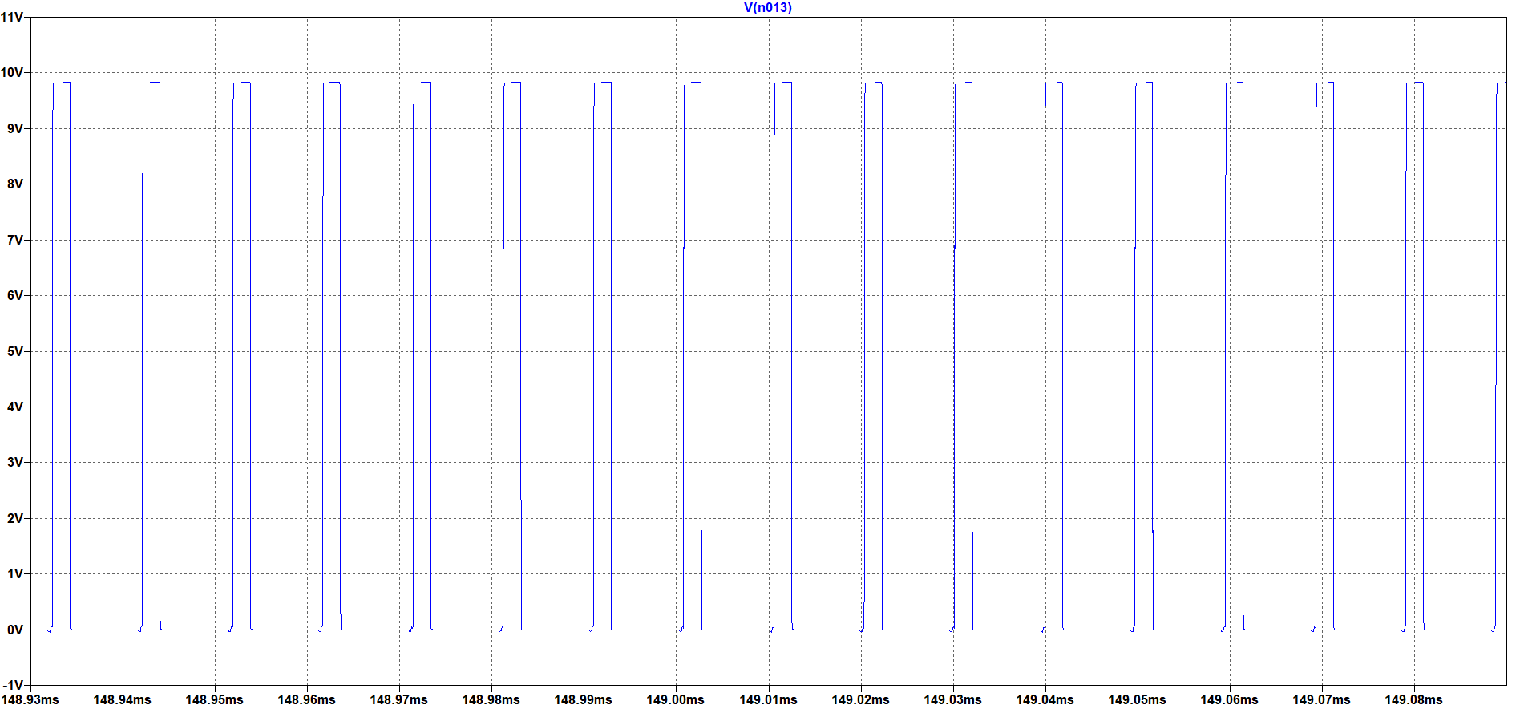
[picture p156: figure]

Figure 7 MOSFET Gate Voltage for 220 V Input Voltage

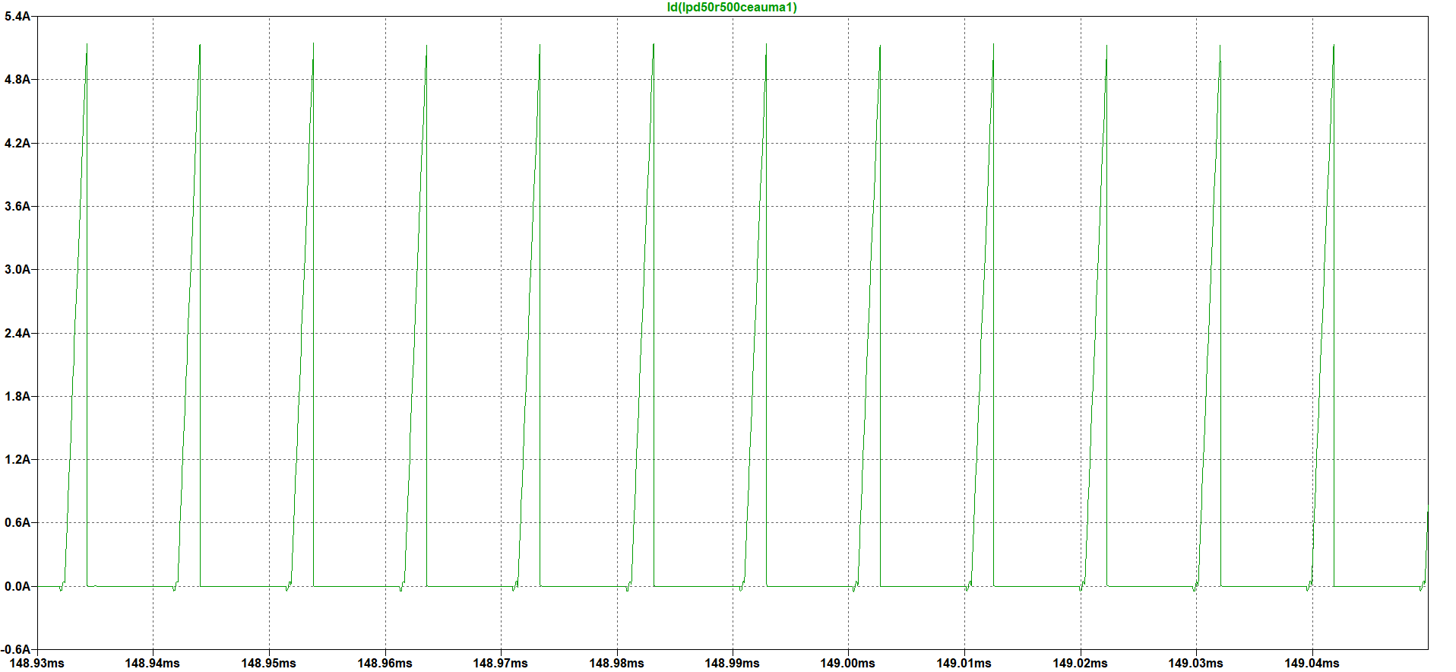
[picture p157: figure]

Figure 8 MOSFET Current for 220 V Input Voltage

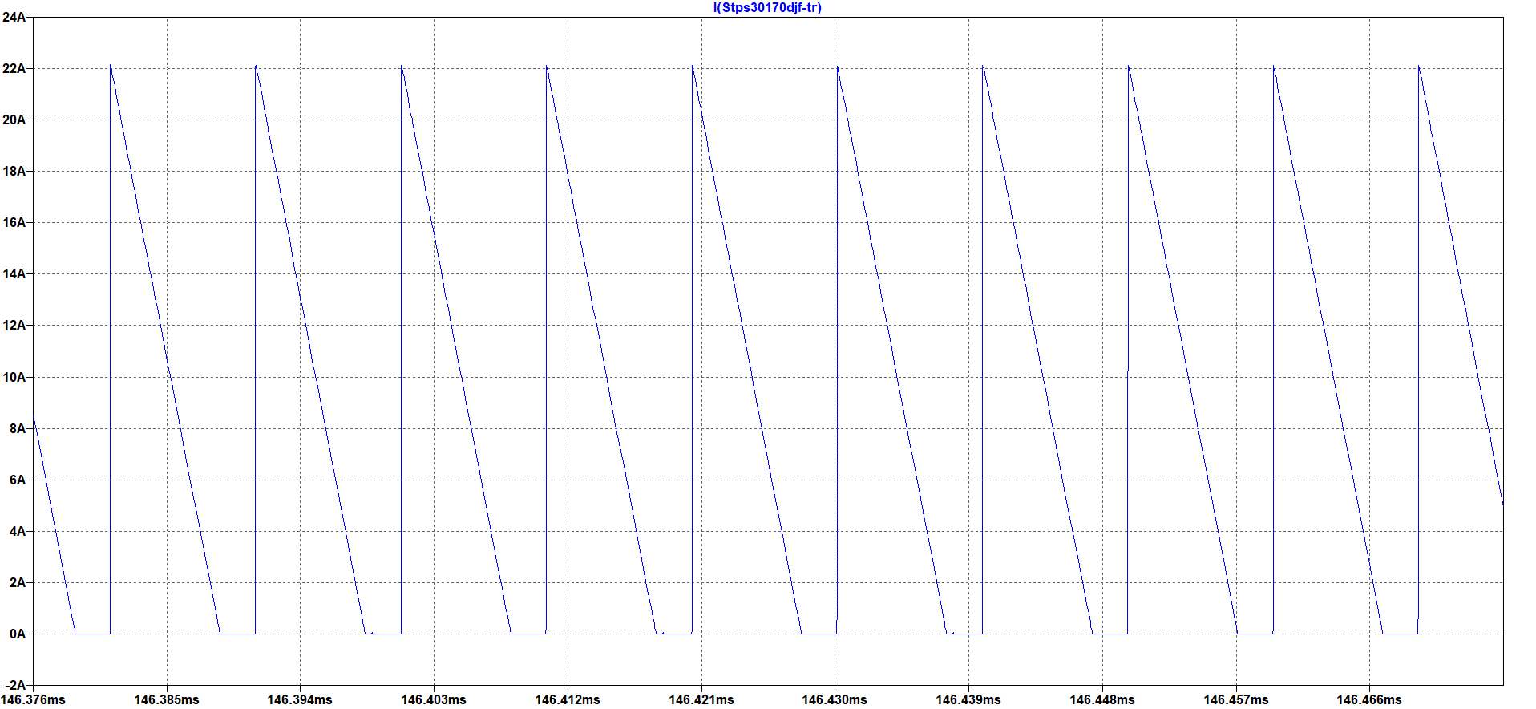
[picture p158: figure]

Figure 9 Output Diode Current for 220 V Input Voltage

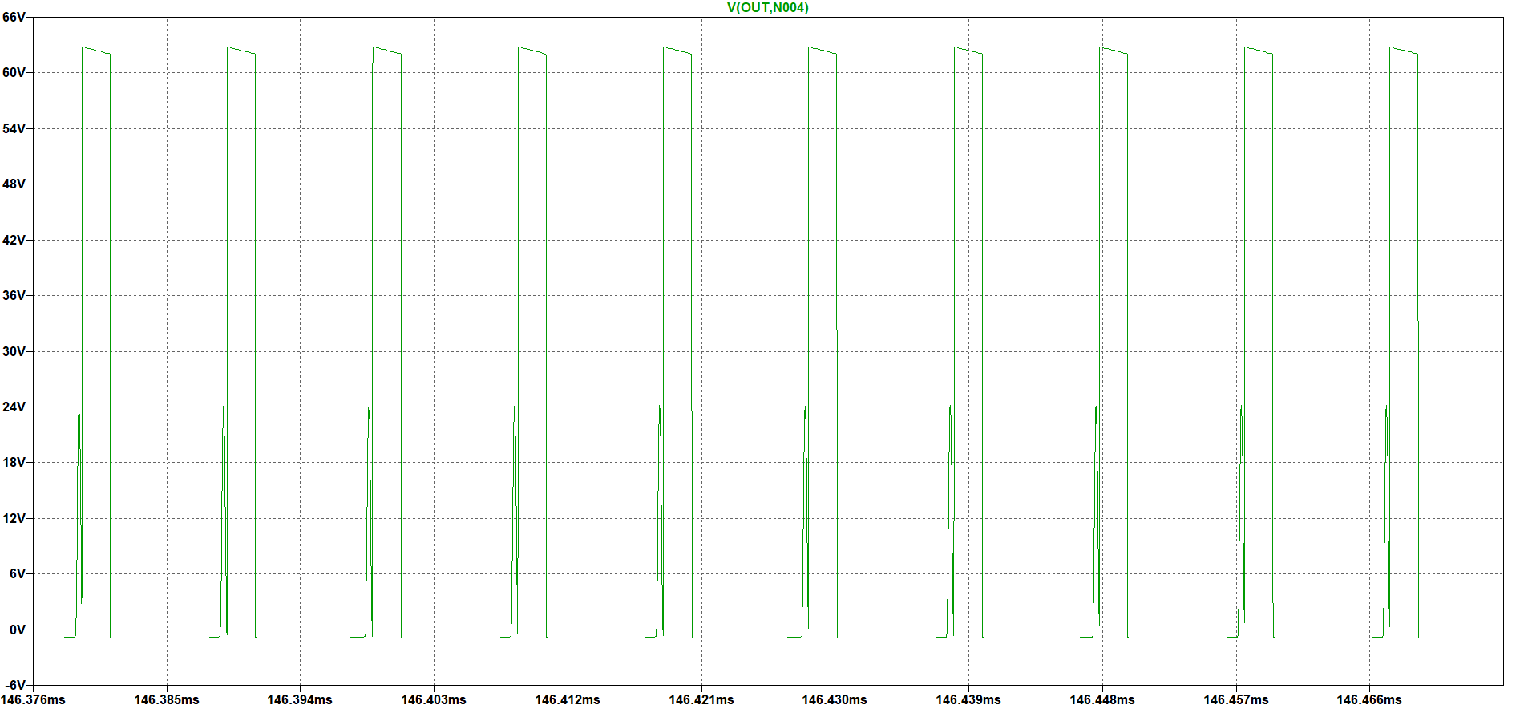
[picture p159: figure]

Figure 10 Output Diode Voltage for 220 V Input Voltage

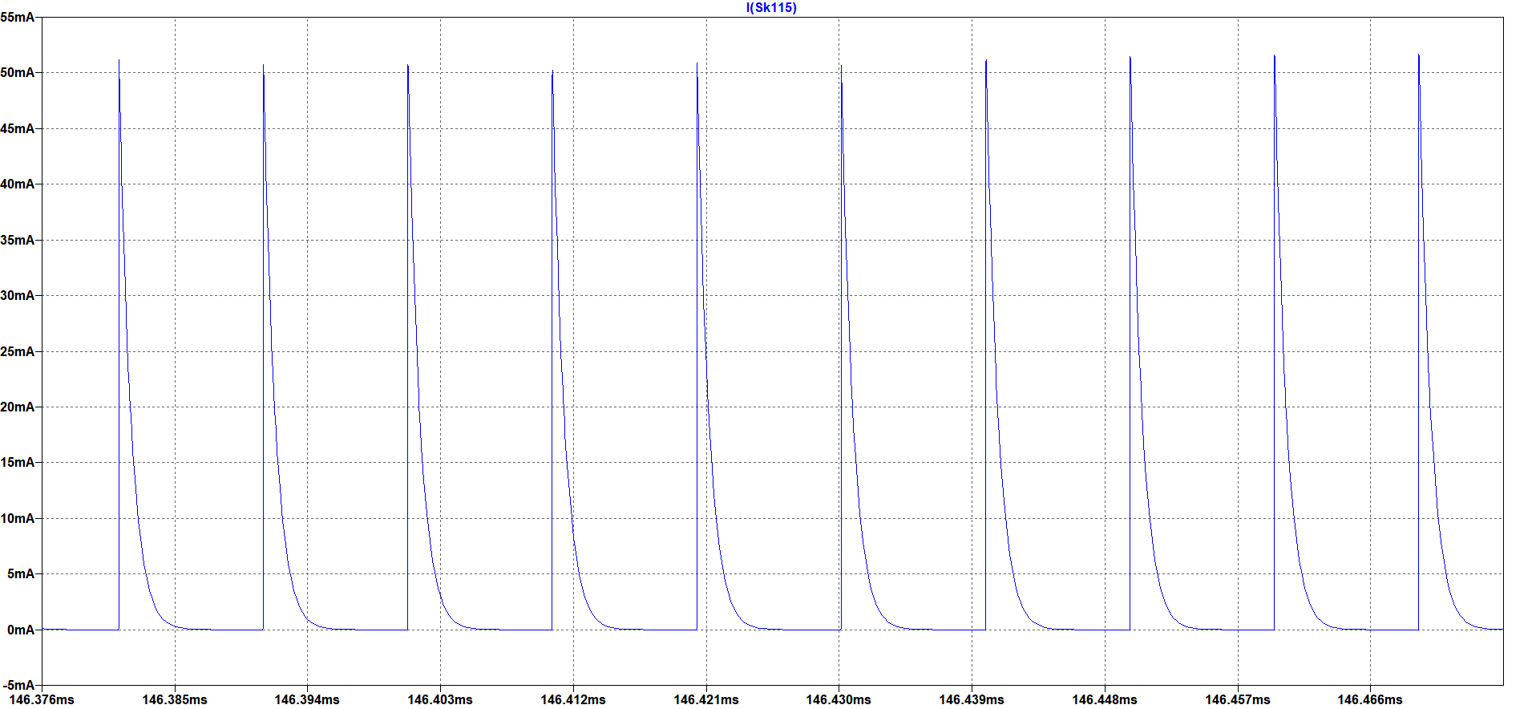
[picture p160: figure]

Figure 11 Tertiary Diode Current for 220 V Input Voltage

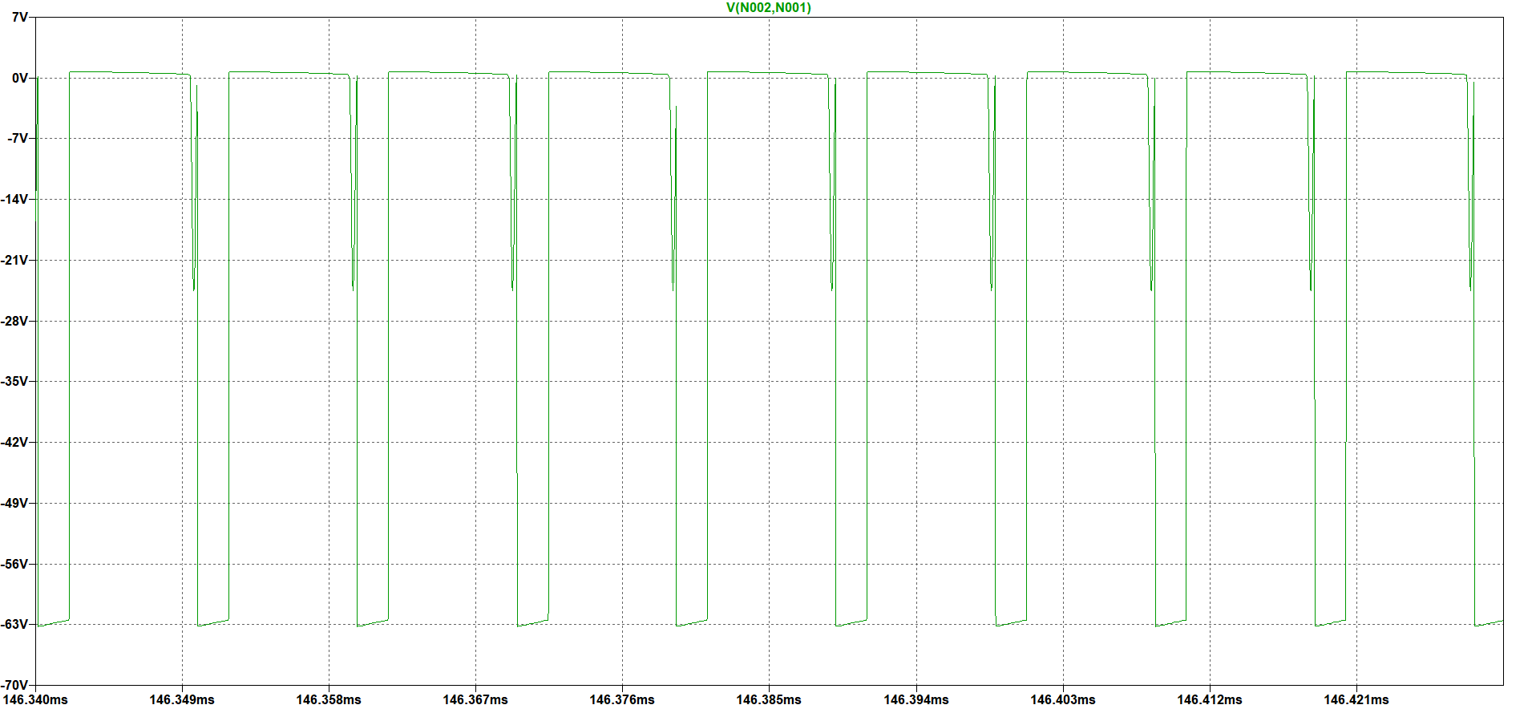
[picture p161: figure]

Figure 12 Tertiary Diode Voltage for 220 V Input Voltage

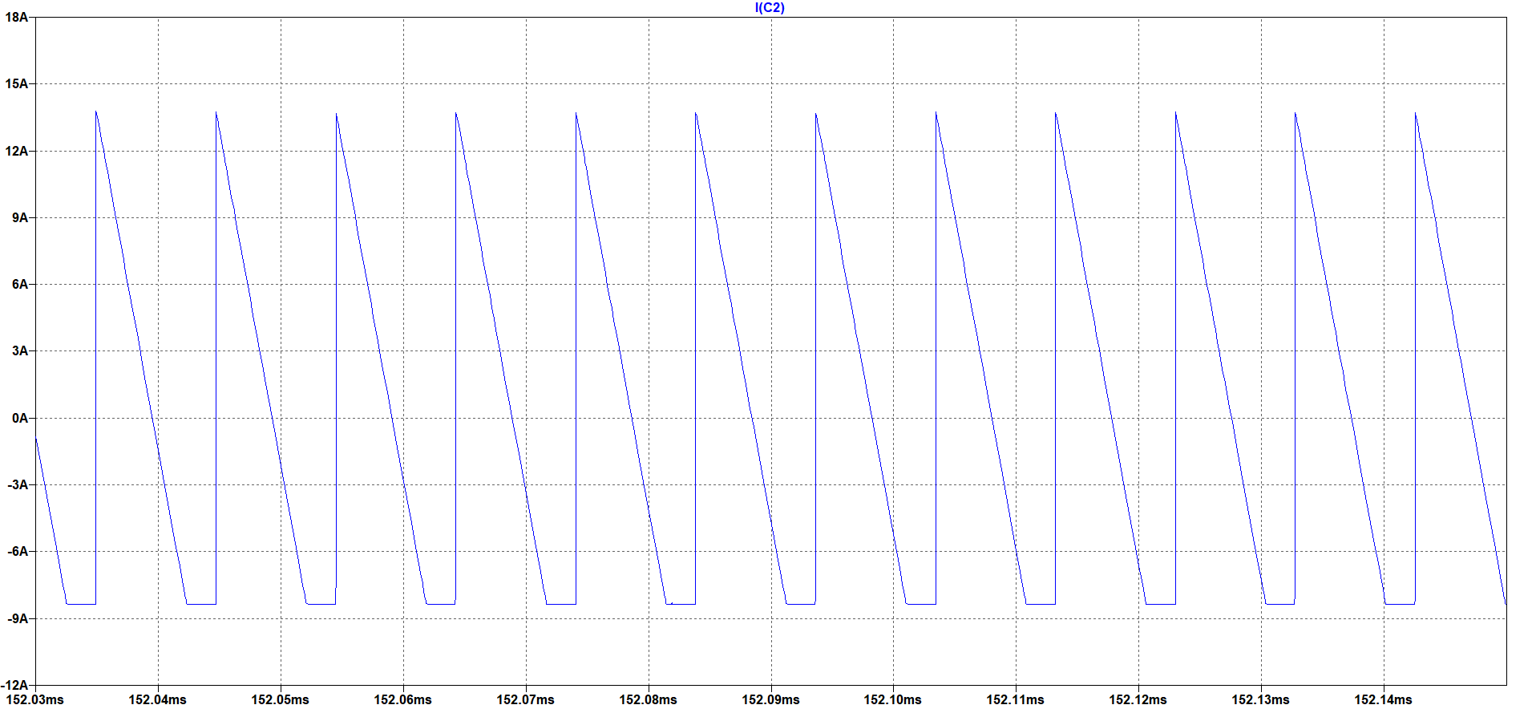
[picture p162: figure]

Figure 13 Output Capacitor Current Ripple for 220 V Input Current

The voltage of output capacitor is the same as the output voltage.

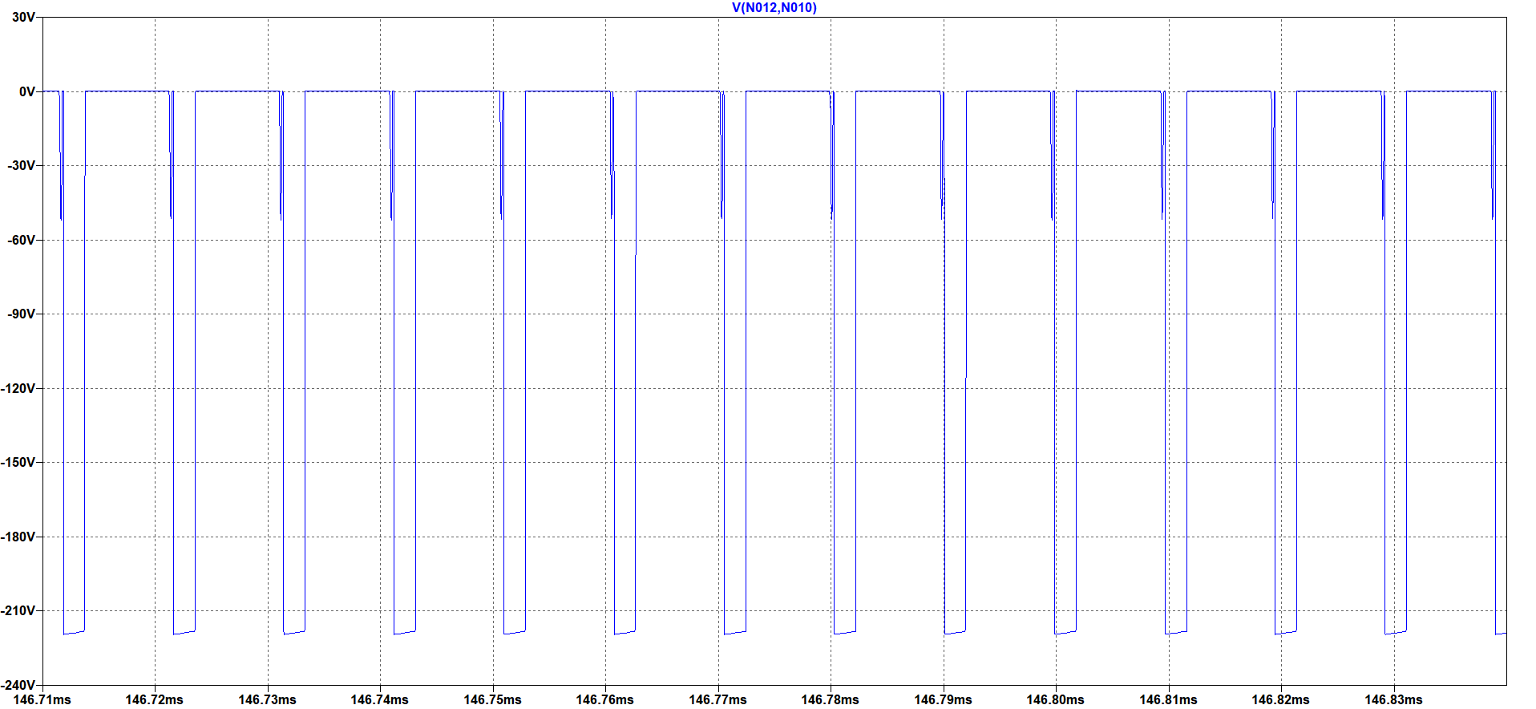
[picture p163: figure]

Figure 14 Snubber Diode Voltage for 220 V Input Voltage

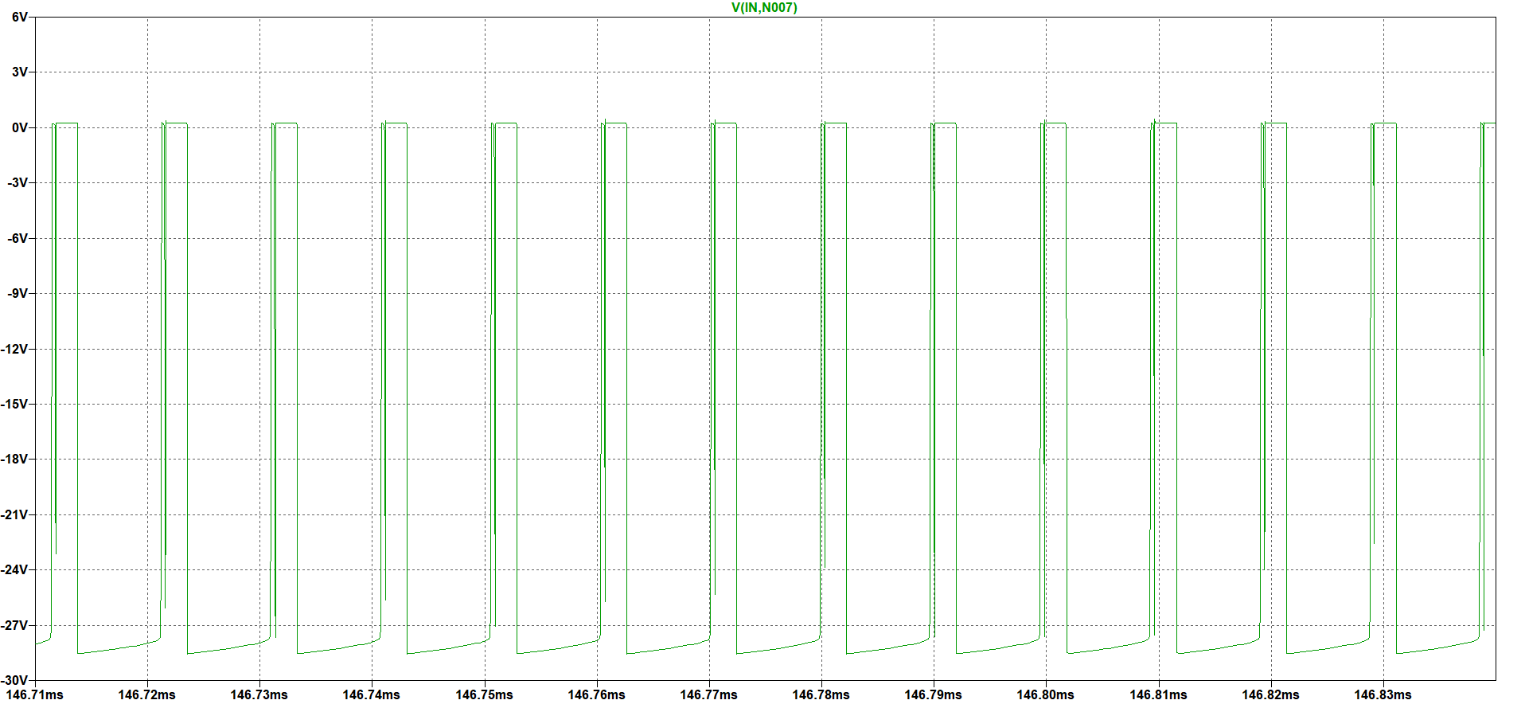
[picture p164: figure]

Figure 15 Zener Diode Voltage for 220V Input Voltage

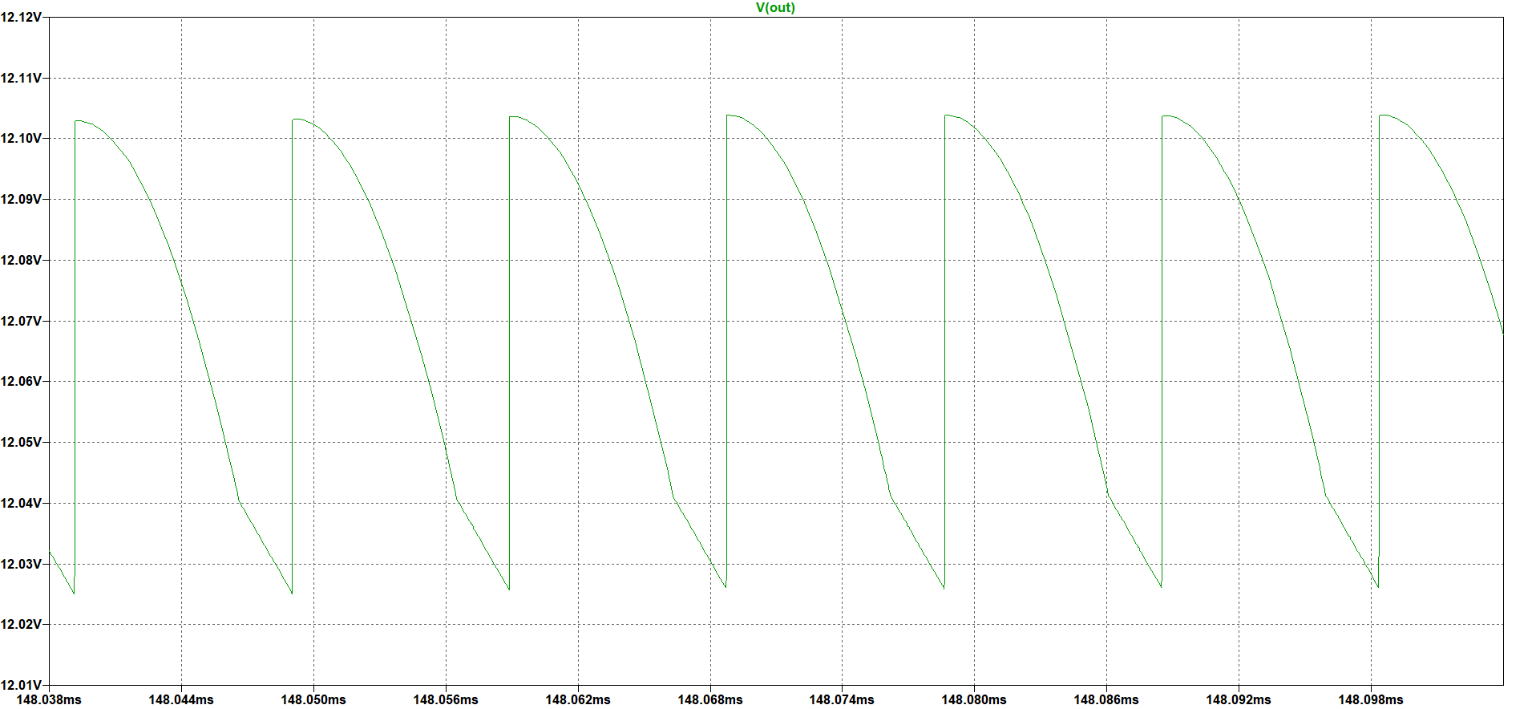
[picture p165: figure]

Figure 16 Output Voltage Ripple for 400V Input Voltage

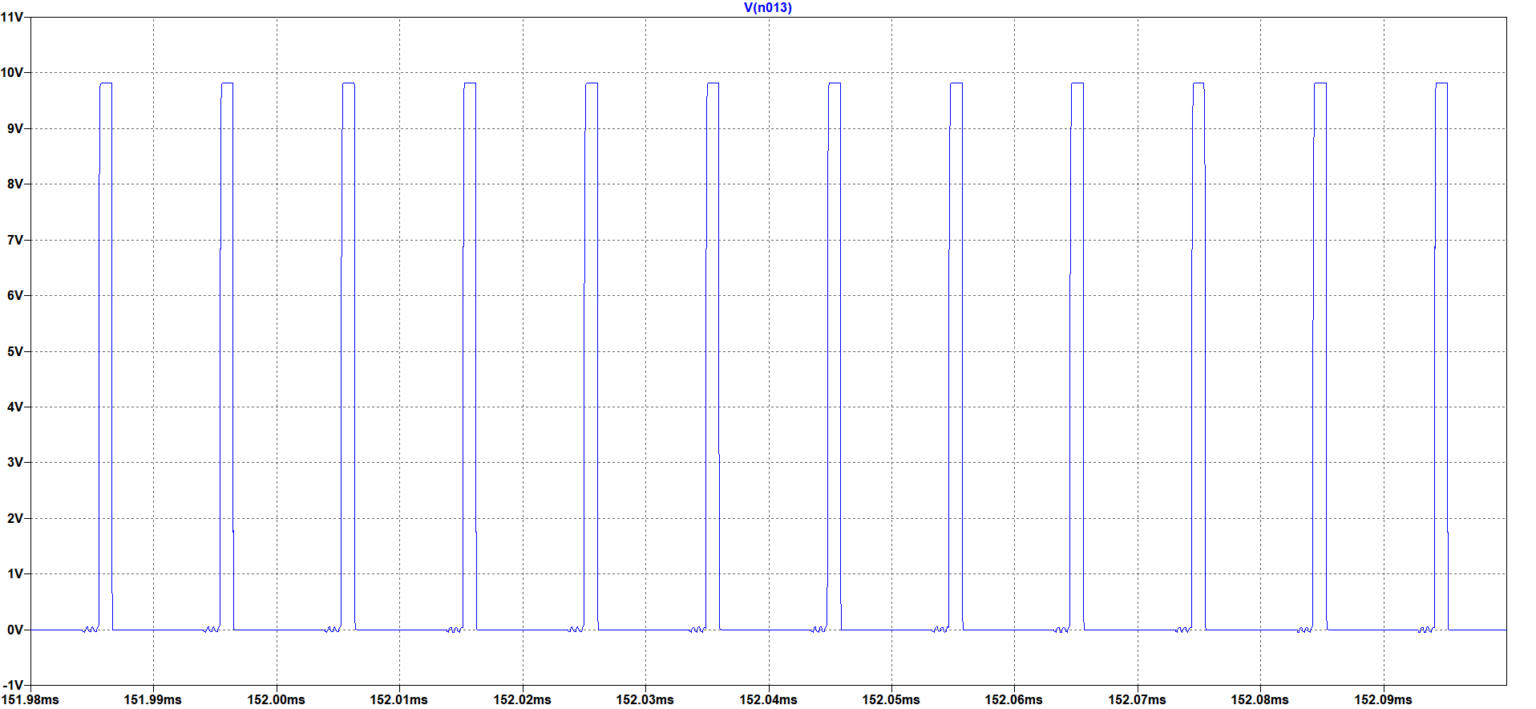
[picture p166: figure]

Figure 17 MOSFET Gate Voltage for 400V Input Voltage

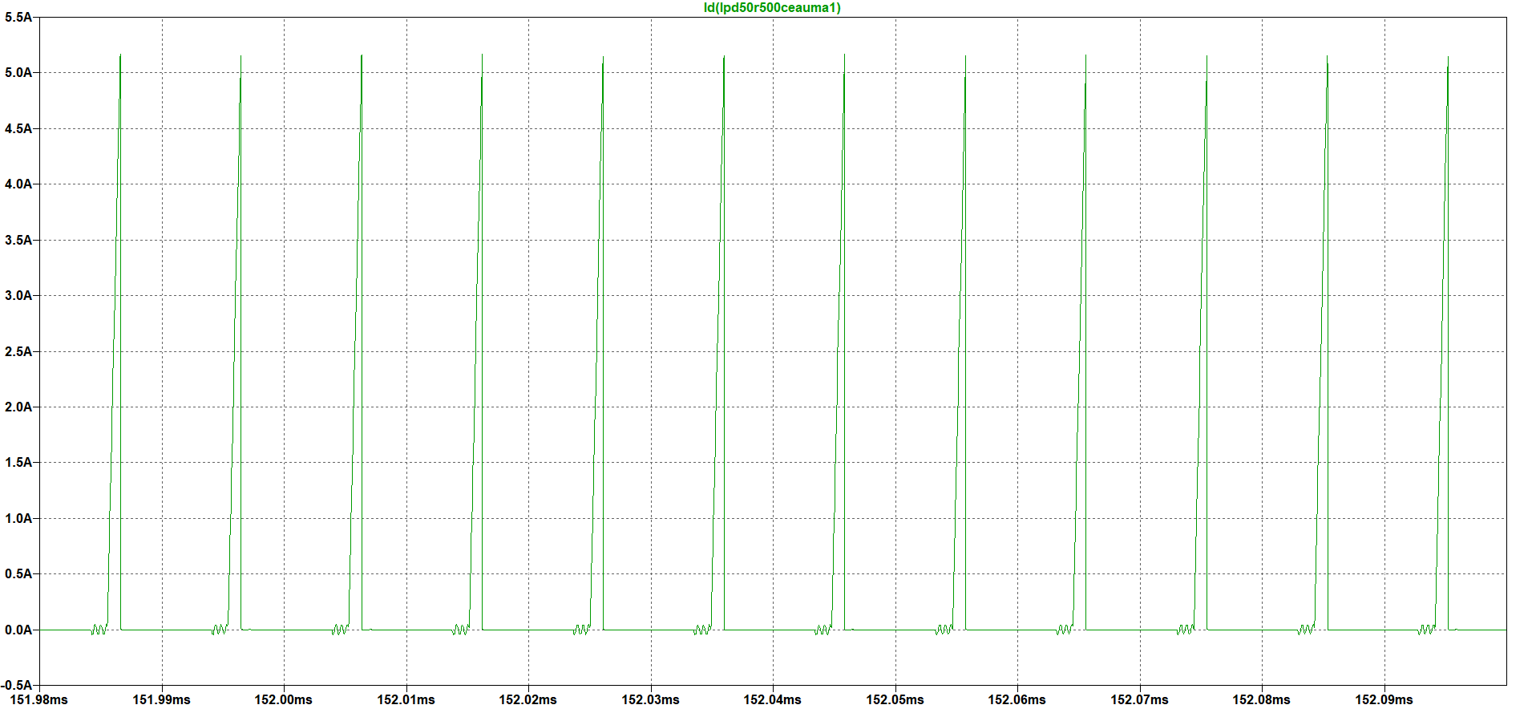
[picture p167: figure]

Figure 18 MOSFET Current for 400V Input Voltage

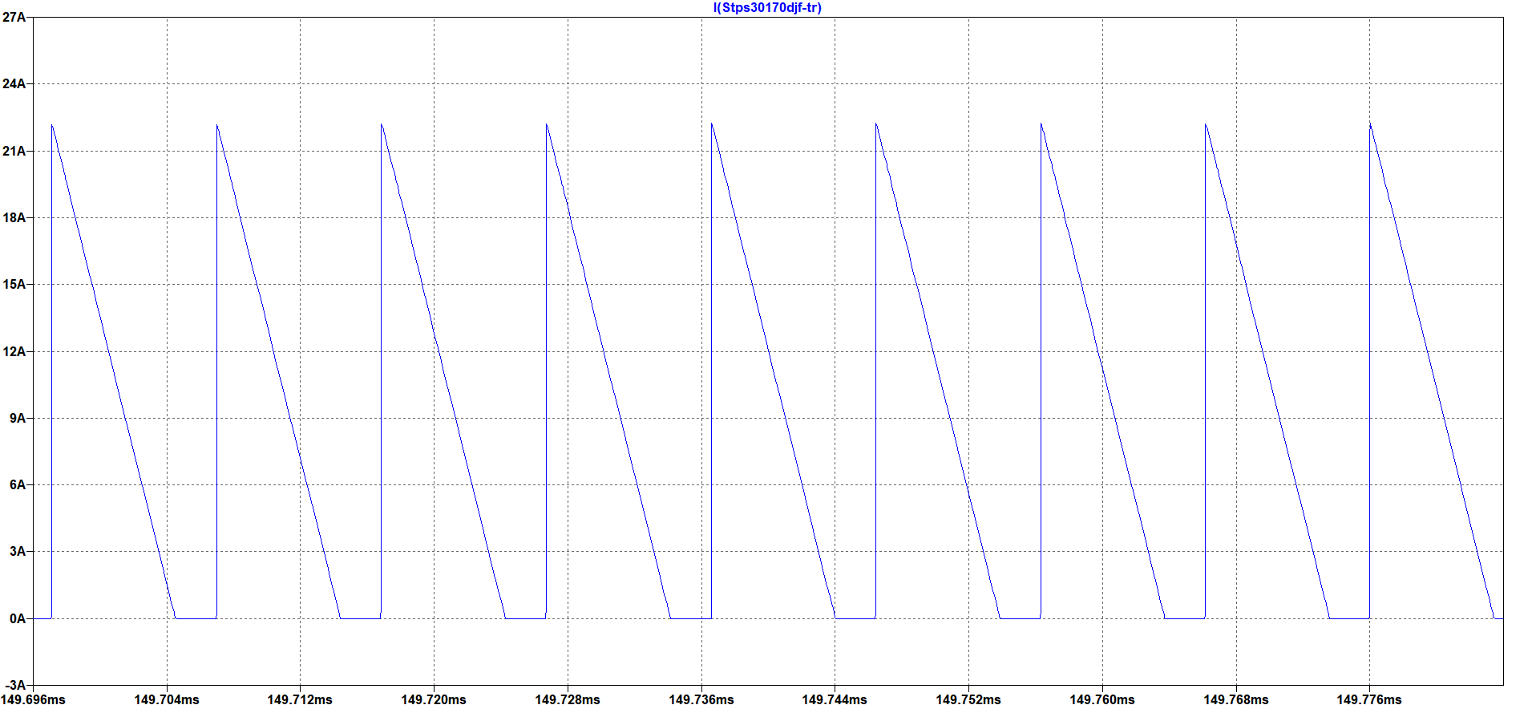
[picture p168: figure]

Figure 19 Output Diode Current for 400 V Input Voltage

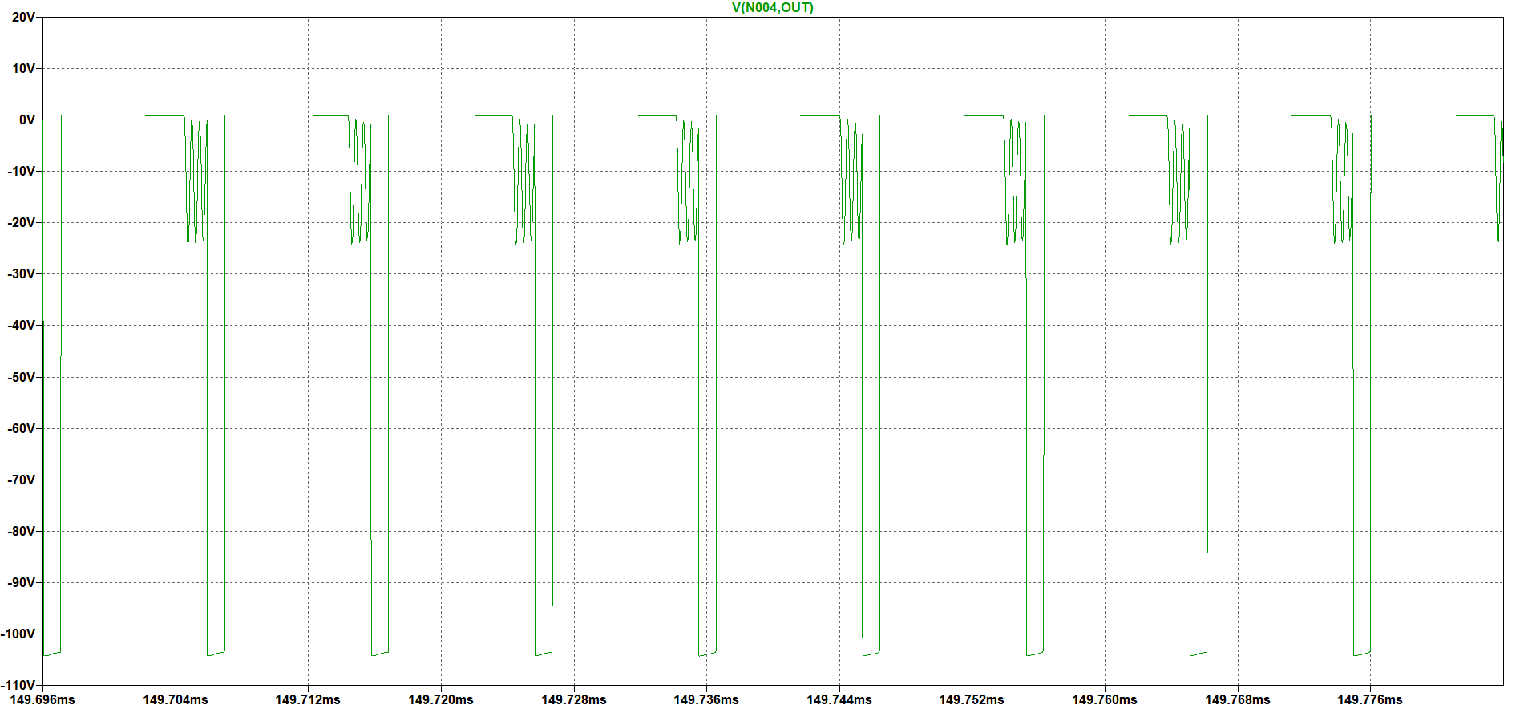
[picture p169: figure]

Figure 20 Output Diode Voltage for 400V Input Voltage

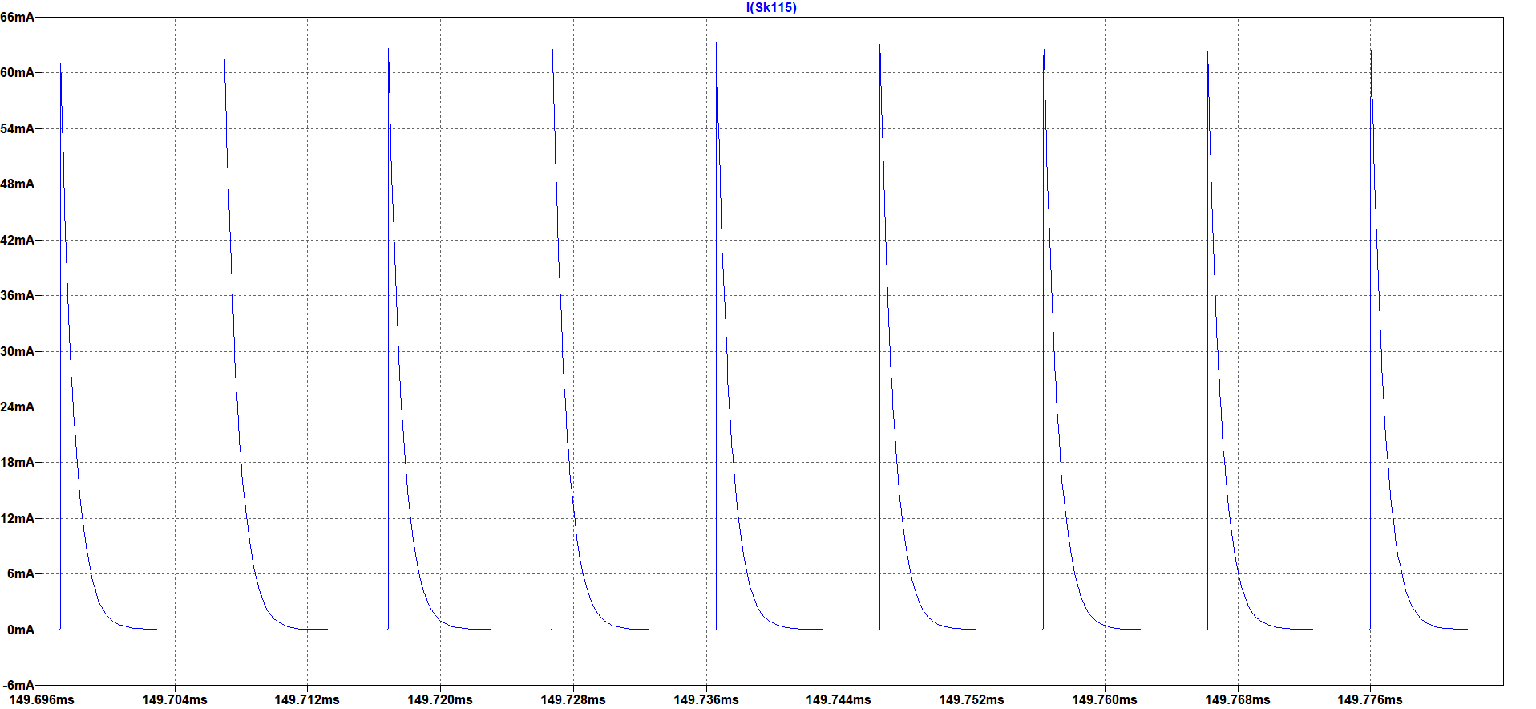
[picture p170: figure]

Figure 21 Tertiary Diode Current for 400V Input Voltage

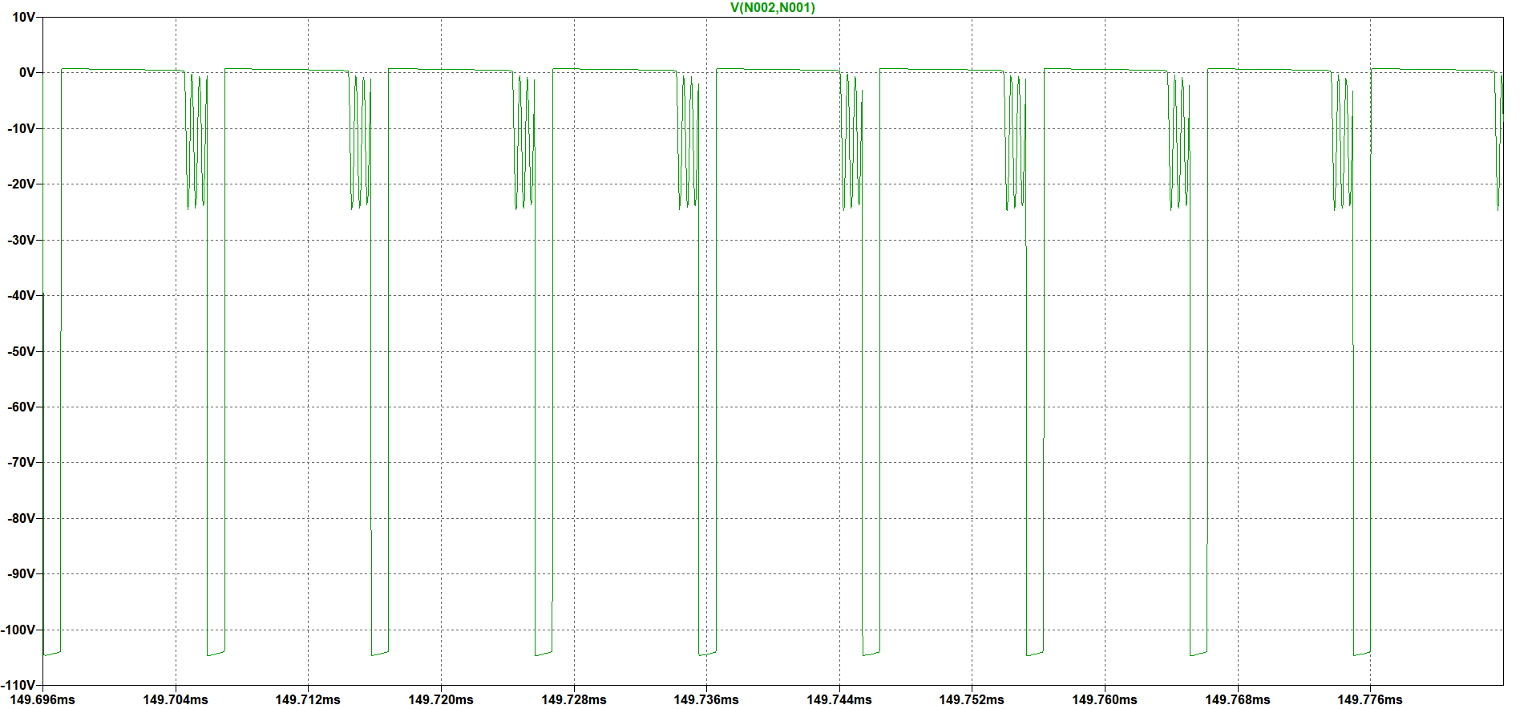
[picture p171: figure]

Figure 22 Tertiary Diode Voltage for 400V Input Voltage

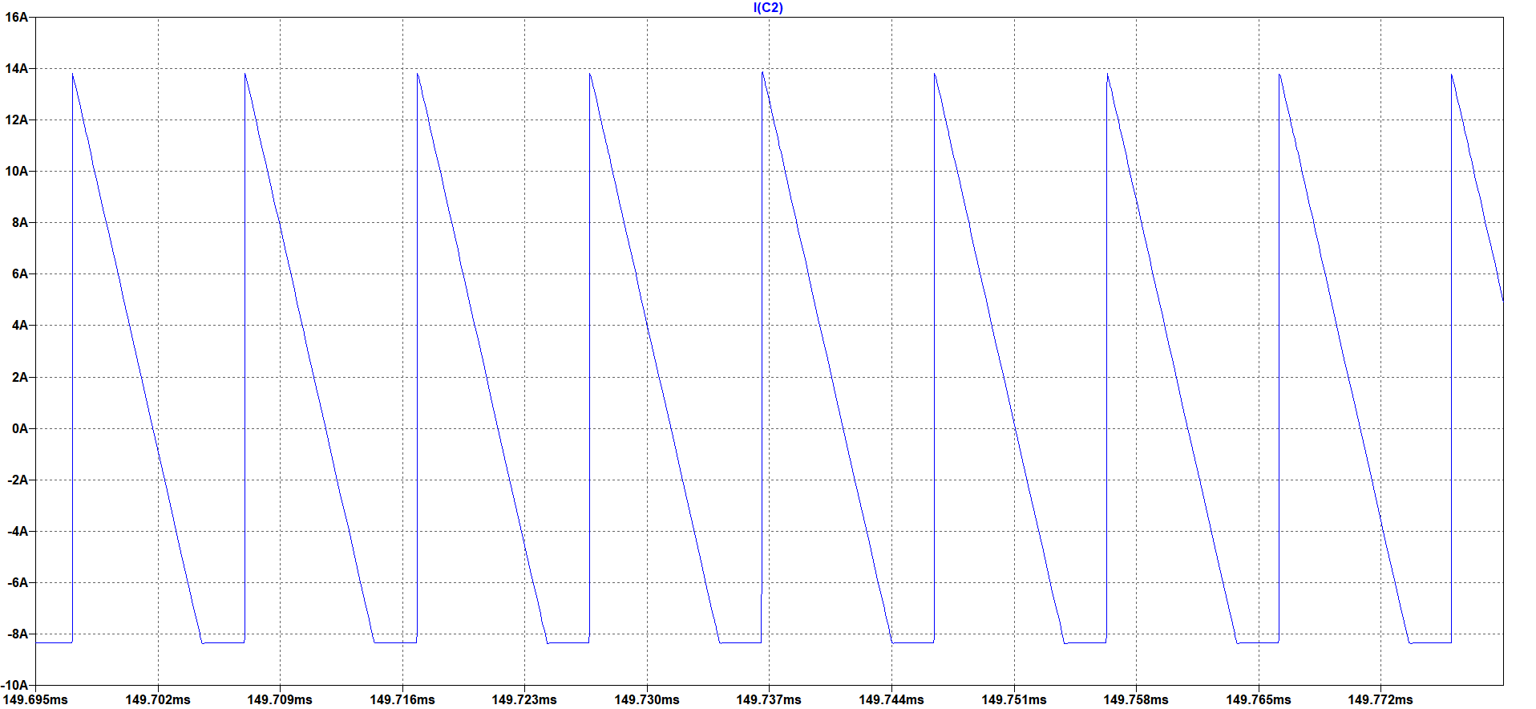
[picture p172: figure]

Figure 23 Output Capacitor Current Ripple for 400V Input Voltage

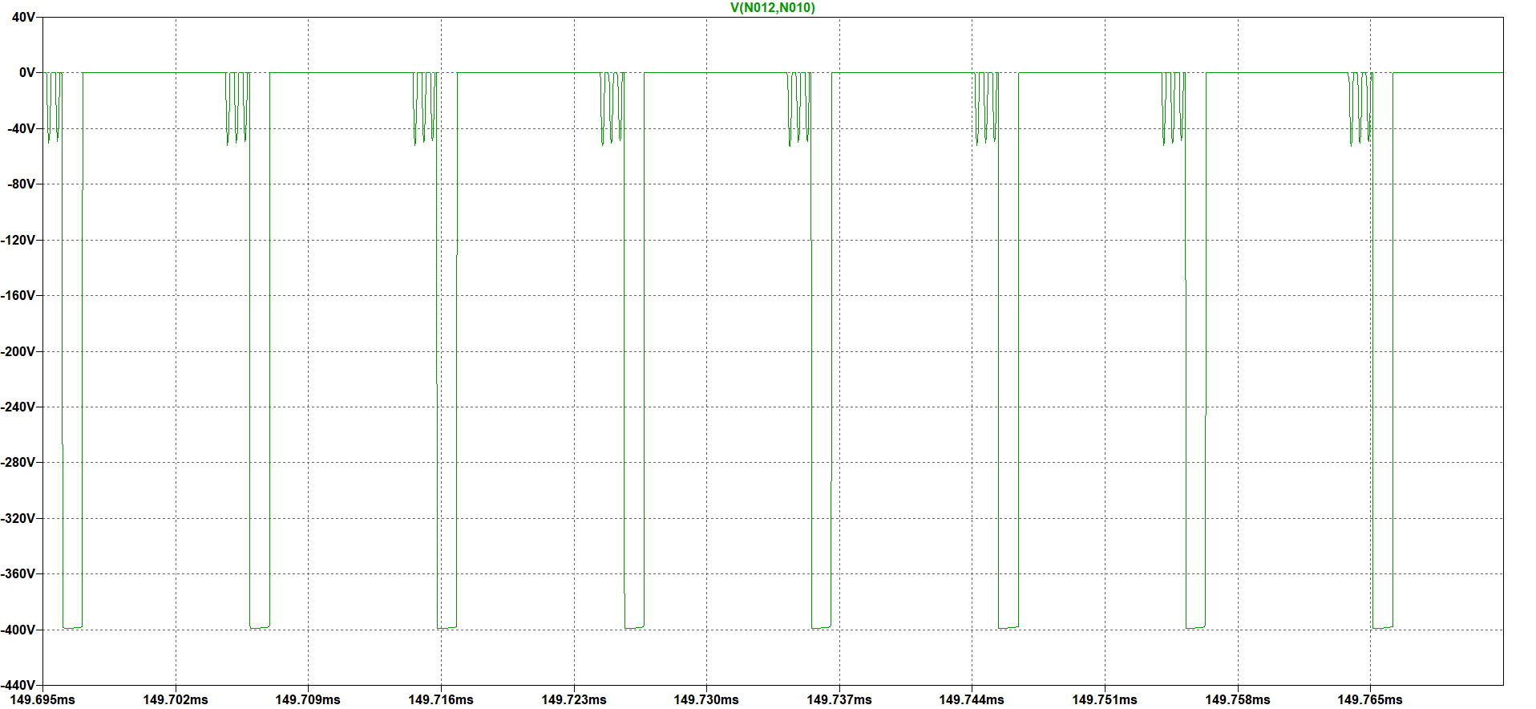
[picture p173: figure]

Figure 24 Snubber Diode Voltage for 400V Input Voltage Ripple

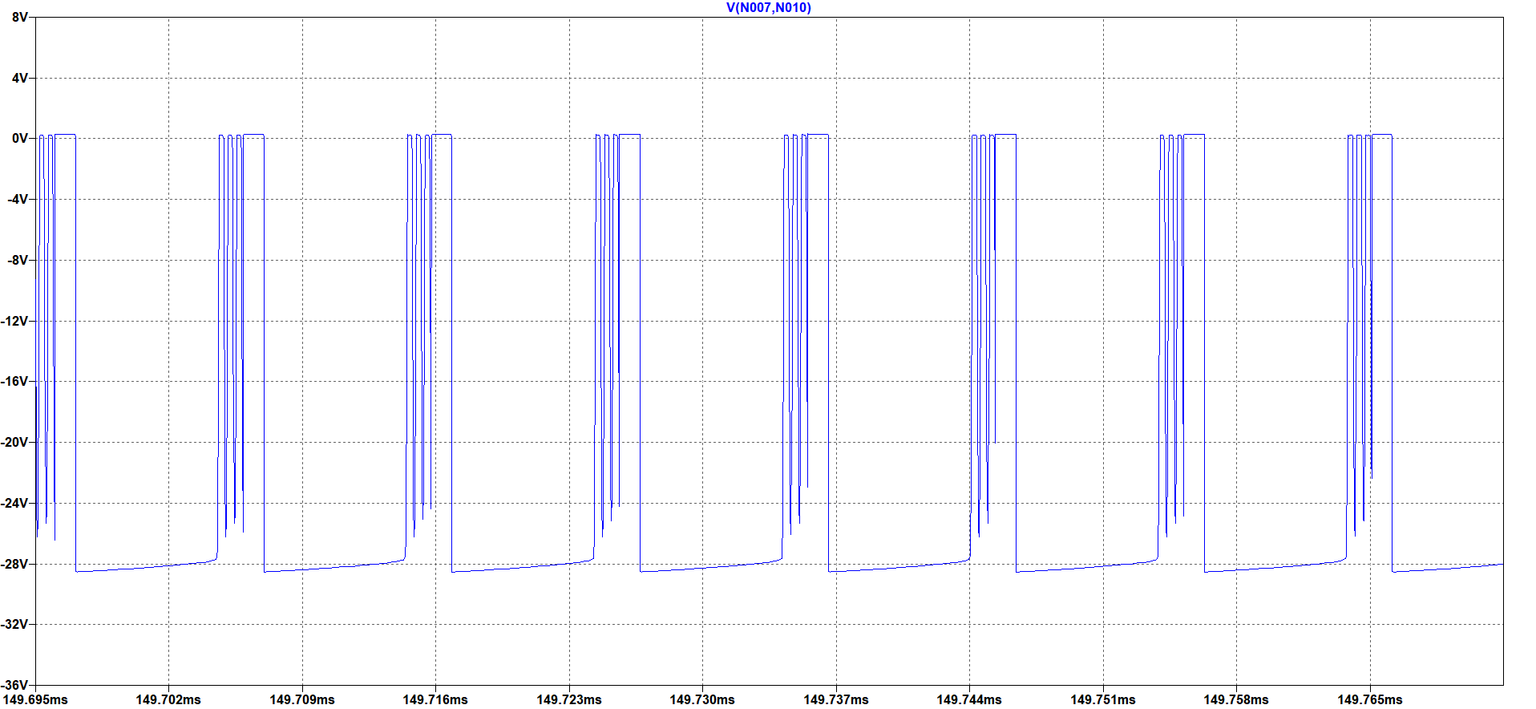
[picture p174: figure]

Figure 25 Snubber Zener Diode Voltage for 400V Input Voltage Ripple
