EnesCanbolat/EE464_Project/Simulations/LT8316_Flyback_v7.asc

C1: cap; 47p
C2: cap; 1.32m; Rser=3.5m
C3: cap; 47p
C4: cap; 4.7µ
C5: cap; 4.7µ
C6: cap; .1µ
C7: cap; 100n
CDBB3150-HF1: diode
CDBB3150-HF2: diode
CDBB3150-HF3: diode
CDBB3150-HF4: diode
CDBB3150-HF5: diode
IPD50R500CEAUMA1: nmos; STW11NM80
L1: ind2; 81.49µ; Rser=0.39
L2: ind2; 4.34µ; Rser=0.009 Cpar=0.5p
L3: ind2; 4.34µ; Rser=0.12
L4: ind; 1.63µ
R1: res; 1.5Meg
R2: res; 56.2K
R3: res; 10K
R4: res; 10m
R5: res; 121K
R6: res; 47K
R7: res; 5K
R8: res; 15k
R9: res; 20
R10: res; 9.2K
R11: res; 10k
R12: res; 0.6
R13: res; 5.6k
Rload: res; 1.44
S1: sw
S1J-E3/61T: diode
SK115: diode
SMAJ440CA: TVSdiode
U1: LT8316
V1: voltage; 220
V2: voltage; PULSE(0 5 149m 1m 0 0 1)
Named nets: 0, IN, OUT
K1 L1 L2 L3 1
4:1:1
.model SK115 D(Ron=1 Roff=10Meg Vrev=150 Vf=0.85V)
.model CDBB3150-HF1 D(Ron=0.48 Roff=10Meg Vrev=150 Vf=0.87)
.model S1J-E3/61T D(Ron=1 Roff=10Meg Vrev=600 Vf=1.1)
.model Z2SMB100 D(Bv=100 Type=Zener)
.model Z2SMB100-2 D(Bv=100 Type=Zener)
.tran 200m startup
.model CDBB3150-HF2 D(Ron=0.48 Roff=10Meg Vrev=150 Vf=0.87)
.model CDBB3150-HF3 D(Ron=0.48 Roff=10Meg Vrev=150 Vf=0.87)
.model CDBB3150-HF4 D(Ron=0.48 Roff=10Meg Vrev=150 Vf=0.87)
.model CDBB3150-HF5 D(Ron=0.48 Roff=10Meg Vrev=150 Vf=0.87)
.model SMAJ440CA D(Ron=113.4583 Roff=880Meg Vfwd=5 epsilon=6 Vrev=648 revepsilon=6 Vpk=400 mfg=Littlefuse type=TVS)
