EnesCanbolat/EE464_Project/(list of files, drawings)

Other design files:
PCB Design/EE464_Project/EE464_PCB.PcbDoc
PCB Design/EE464_Project/EE464_Project.PrjPcb
PCB Design/EE464_Project/EE464_SCH.SchDoc
