EnesCanbolat/EE464_Project/(commit log)

2021-04-17 Calculation Tool for flyback is added
    [Calculation-Tool-FPS--FLYBACK.XLS]
2021-04-19 A sample simulation model has been constructed.
2021-04-24 Two voltage limit simulation is added
2021-04-26 Report draft about analytical calculations and magnetic design is added
2021-04-28 Some minor changes in component selection report, hardware design report and BOM has been constructed, Altium project has been added.
    [EE464_PCB.PcbDoc, EE464_Project.PrjPcb, EE464_Project_BOM.xlsx, EE464_SCH.SchDoc, bom.xlsx]
2021-04-29 BOM is added to report.
2021-04-30 Some file arrangments were made
    [bom.xlsx]
2021-05-30 Power loss m file is added
2021-05-30 Power related text is written
2021-06-03 Winding design and Power loss calculations are completed
2021-06-03 Leakage inductance and gate resistors have been added to the simulation
2021-06-05 Power and Thermal calculations are done
2021-06-13 RCD snubber circuit is added to calculations
2021-06-13 Schematic design and libraries concluded, PCB design has been started.
    [EE464_PCB.PcbDoc, EE464_SCH.SchDoc]
2021-06-17 Layout is constructed.
    [EE464_PCB.PcbDoc, EE464_SCH.SchDoc]
2021-06-21 PCB is complete.
    [EE464_PCB.PcbDoc, EE464_Project.PrjPcb]
2021-06-22 Some updates on PCB, Final BOM is constructed, PCB validations for report is constructed.
    [EE464_PCB.PcbDoc, EE464_Project_2206.xlsx, Final BOM.xlsx]
2021-07-02 Voltage Waveform on MOSFET with and without snubber circuit versions were added
